rlemubaghs/open_mrscope/images/microscope_artifacts.png

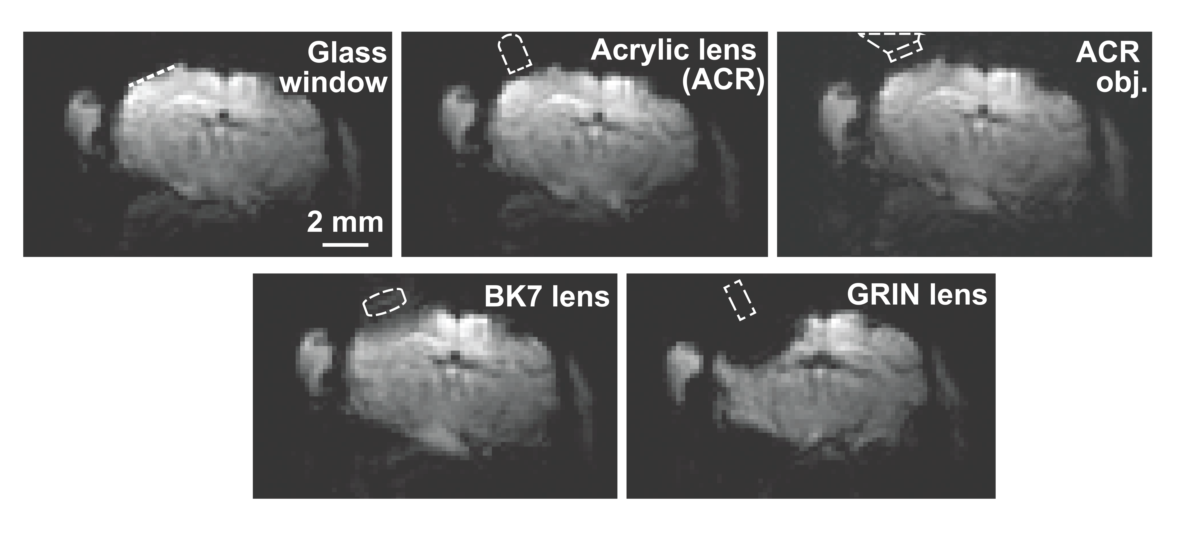
images/microscope_artifacts.png
