rlemubaghs/open_mrscope/images/microscope_overview.png

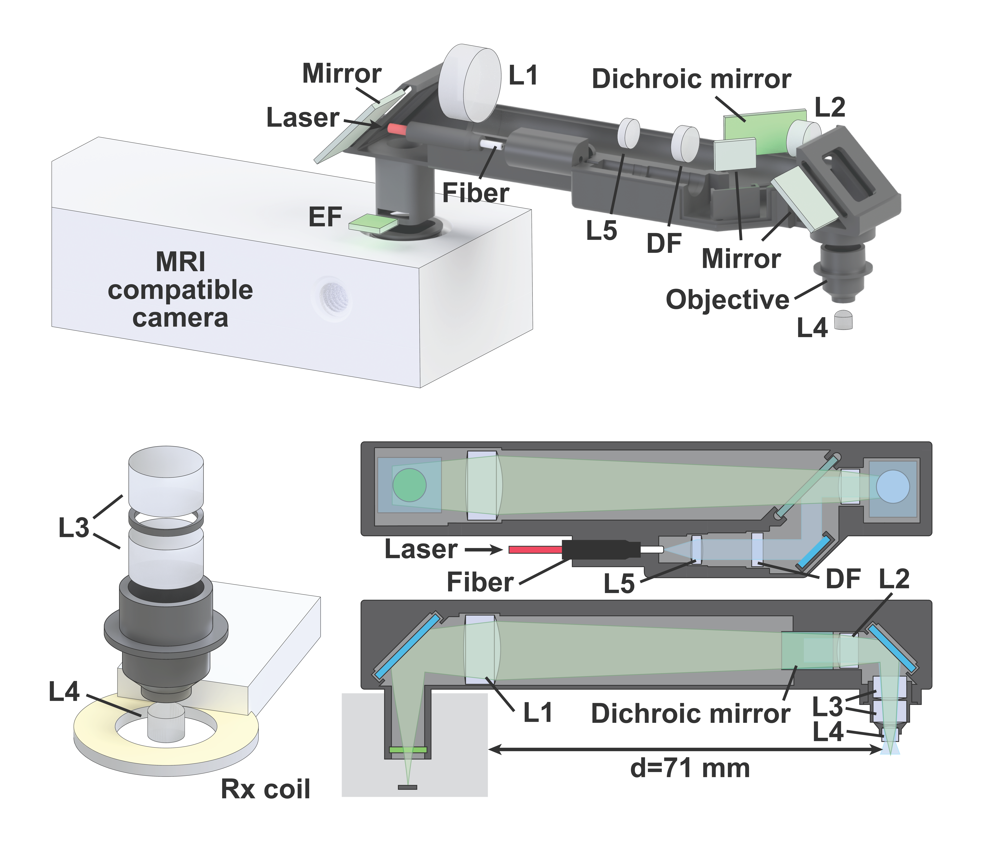
images/microscope_overview.png
