rlemubaghs/open_mrscope/documentation/order_list.docx

Ordered items

Item | # | Manufacturer | Link | Note
EO #15-271 | 1 | Edmund Optics | https://www.edmundoptics.com/p/3mm-dia-x-299mm-fl-small-diameter-plastic-aspheric-lens/43154/
EO #36-629 | 2 | Edmund Optics | https://www.edmundoptics.com/p/6mm-dia-x-8mm-fl-small-diameter-plastic-aspheric-lens/34654/ | Scratch sensitive
EO #47-662 | 1 | Edmund Optics | https://www.edmundoptics.com/p/125mm-dia-x-25mm-fl-vis-0deg-coated-achromatic-lens/7769/
EO #47-690 | 1 | Edmund Optics | https://www.edmundoptics.com/p/625mm-dia-x-125mm-fl-vis-0deg-coated-achromatic-lens/7810/
EO #63-594 | 1 | Edmund Optics | https://www.edmundoptics.com/p/5mm-dia-x-5mm-fl-vis-0deg-coated-double-convex-lens/18227/
EO #63-594 | 1 | Edmund Optics | https://www.edmundoptics.com/p/5mm-dia-x-5mm-fl-vis-0deg-coated-double-convex-lens/18227/
Custom fiber | 1 | Thorlabs | https://www.thorlabs.com/newgrouppage9.cfm?objectgroup_id=2410 | SM FC/PC; Ferrule; FP400ERT
OBIS LX/LS Series | 1 | Coherent | https://www.coherent.com/lasers/cw-solid-state/obis-ls-lx | 488 nm GCaMP; 561 nm RCaMP
HighResolution | 1 | MRC Systems | https://www.mrc-systems.de/de/produkte/mr-kompatible-kameras#hires-mrcam | Contact: m.goetz@mrc-systems.de
ET Dualband beamsplitter FITC/CY3 | 1 | AHF | https://ahf.de/produkte/spektralanalytik-photonik/optische-filter/strahlenteiler-nach-anwendung/epi-fluoreszenz/et-dualband-bs-fitc-cy3/F58-023 | 14.5 x 8 mm
350-700 nm imaging mirror | 1 | AHF | https://ahf.de/produkte/spektralanalytik-photonik/optische-filter/spiegel/350-700-nm-spiegel-imaging/F29-350 | 16.5 x 11.5 mm
350-700 nm imaging mirror | 1 | AHF | https://ahf.de/produkte/spektralanalytik-photonik/optische-filter/spiegel/350-700-nm-spiegel-imaging/F29-350 | 8.5 x 11.5 mm
350-700 nm imaging mirror | 1 | AHF | https://ahf.de/produkte/spektralanalytik-photonik/optische-filter/spiegel/350-700-nm-spiegel-imaging/F29-350 | 8 x 5.5 mm
ET Dualband Emitter FITC/CY3 | 1 | AHF | https://ahf.de/en | 6.5 x 6.5 mm
edc-10 | 1 | Rochester | https://lso.viavisolutions.com/product/edc-10/ | ⌀ 6 mm
M1.2 PEEK Countersink Screws | - | HP Polymer | https://highperformancepolymer.co.uk/en-ch/collections/peek-screws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 | Various length M1.2
M2 PEEK Countersink Screws | - | HP Polymer | https://highperformancepolymer.co.uk/en-ch/collections/peek-screws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 | Various length M2

Custom manufactured items

All items can be found in the /open_mrscope_mk2 folder as threaded and non-threaded version

Item | # | Prod. | Material | Note
adaptor_camera_mk1 | 1 | CNC | PEEK | Adopt threading to camera model
adaptor_cameralock_mk1 | 1 | CNC | Titanium | Use Grade II to minimize artifacts
adaptor_lightsource_mk1 | 1 | CNC | PEEK
adaptor_lightsourceangle_mk1 | 1 | CNC | PEEK
construction_objective_mk1 | 1 | CNC | PEEK
microscope_cameracoupler_mk1 | 1 | CNC | PEEK
microscope_filtercube_mk1 | 1 | CNC | PEEK
microscope_mirrorlockback_mk1 | 1 | CNC | PEEK
microscope_mirrorlockfront_mk1 | 1 | CNC | PEEK
microscope_mirrorlocktop_mk1 | 1 | CNC | PEEK
microscope_objective_mk1 | 1 | CNC | PEEK
microscope_objectivecoupler_mk1 | 1 | CNC | PEEK
microscope_opticaltube_mk1 | 1 | CNC | PEEK
microscope_spacer_mk1 | 1 | CNC | PEEK | Recommended spares: 3
microscope_support_mk1 | 1 | CNC/SLA/DLP | PEEK/HDT180 | Loctite 3D 3860 HDT180
microscope_supportlock_mk1 | 1 | CNC/SLA/DLP | PEEK/HDT180 | Loctite 3D 3860 HDT180
