rlemubaghs/open_mrscope/open_mrscope_mk2/production_nothread/stp/assemblies/assemblies_opticalsystem.stp

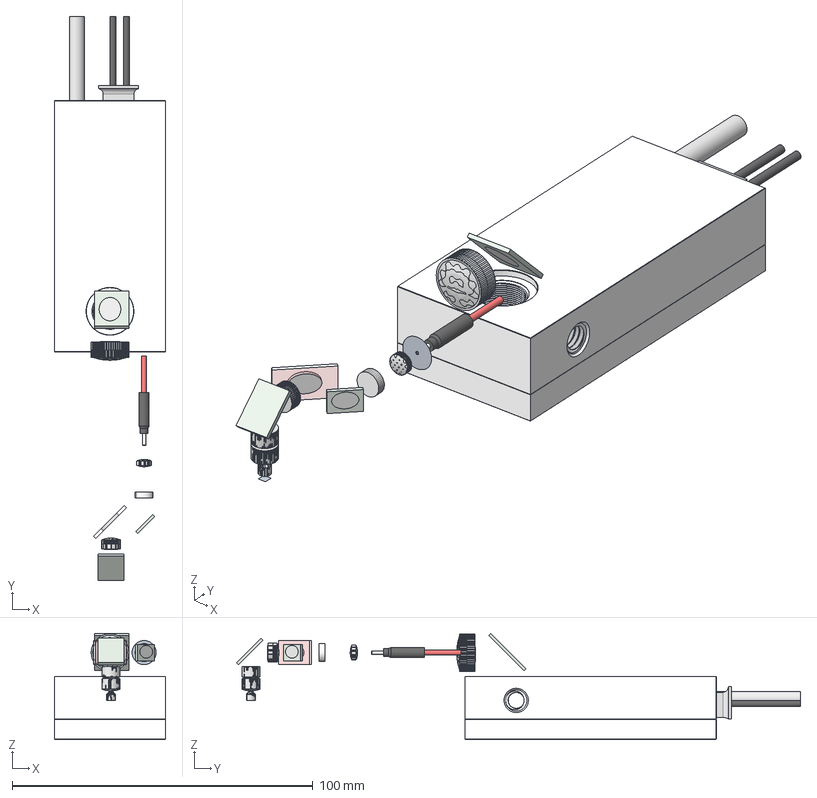
[picture p4: CAD file, 2025-03-11]
open_mrscope_mk2/production_nothread/stp/assemblies/assemblies_opticalsystem.stp
37.0 x 187.5 x 35.2 mm
filter_dichroic_ext
Filters_Diffuser_ext
Filters_Emmiter_ext
lens_15271_ext
lens_36629_ext x 2
lens_47662_ext
Lenses_47690_ext
Lenses_63594_ext
mirror_mirror10x16mm_ext
mirror_mirror5x7mm_ext
mirror_mirror8x11mm_ext
Peripherals_Cam_ext
Peripherals_Fiber_ext
filter_diffuser_ext
