rlemubaghs/open_mrscope/open_mrscope_mk2/production_nothread/stl/optics/filters/filter_emmiter_ext.stl

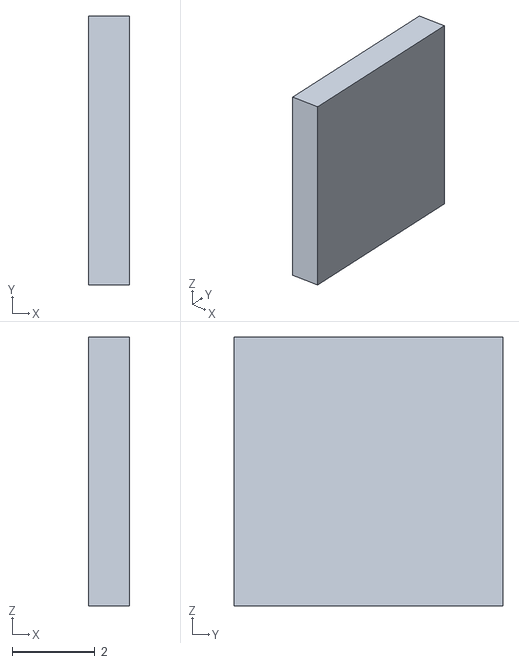
[picture p6: CAD file, 2025-03-11]
open_mrscope_mk2/production_nothread/stl/optics/filters/filter_emmiter_ext.stl
1.00 x 6.50 x 6.50
