rlemubaghs/open_mrscope/open_mrscope_mk2/production_nothread/stl/optics/lenses/lens_15271_ext.stl

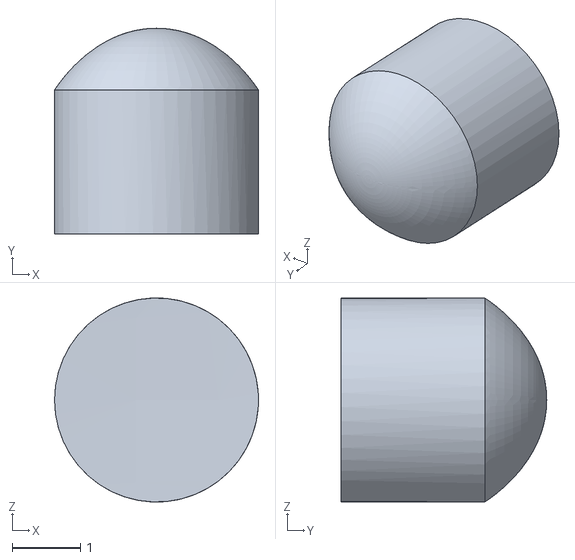
[picture p7: CAD file, 2025-03-11]
open_mrscope_mk2/production_nothread/stl/optics/lenses/lens_15271_ext.stl
3.00 x 3.02 x 3.00
