rlemubaghs/open_mrscope/open_mrscope_mk2/production_nothread/stp/adaptors/adaptor_camera_mk1.stp

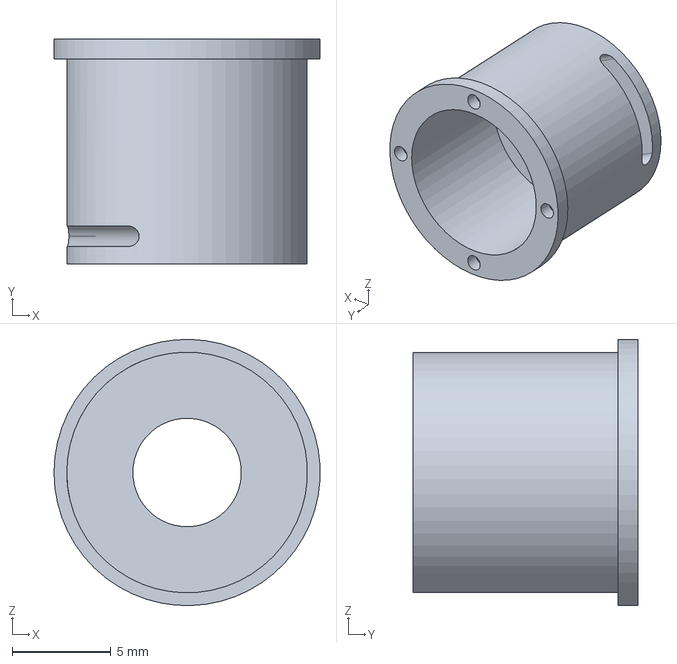
[picture p8: CAD file, 2025-03-11]
open_mrscope_mk2/production_nothread/stp/adaptors/adaptor_camera_mk1.stp
13.5 x 11.4 x 13.5 mm
