rlemubaghs/open_mrscope/open_mrscope_mk2/production_nothread/stp/construction/construction_objective_mk1.stp

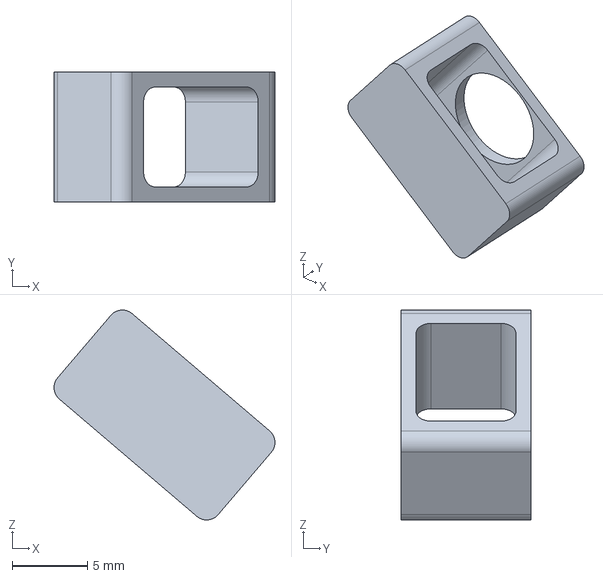
[picture p9: CAD file, 2025-03-11]
open_mrscope_mk2/production_nothread/stp/construction/construction_objective_mk1.stp
14.7 x 8.62 x 13.9 mm
