rlemubaghs/open_mrscope/open_mrscope_mk2/production_nothread/stp/microscope/microscope_mirrorlockback_mk1.stp

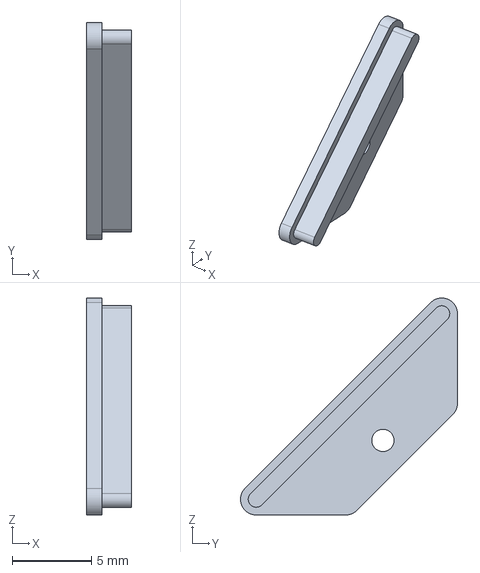
[picture p10: CAD file, 2025-03-11]
open_mrscope_mk2/production_nothread/stp/microscope/microscope_mirrorlockback_mk1.stp
2.87 x 13.7 x 13.7 mm
