rlemubaghs/open_mrscope/open_mrscope_mk2/production_nothread/stp/optics/filters/filter_diffuser_ext.stp

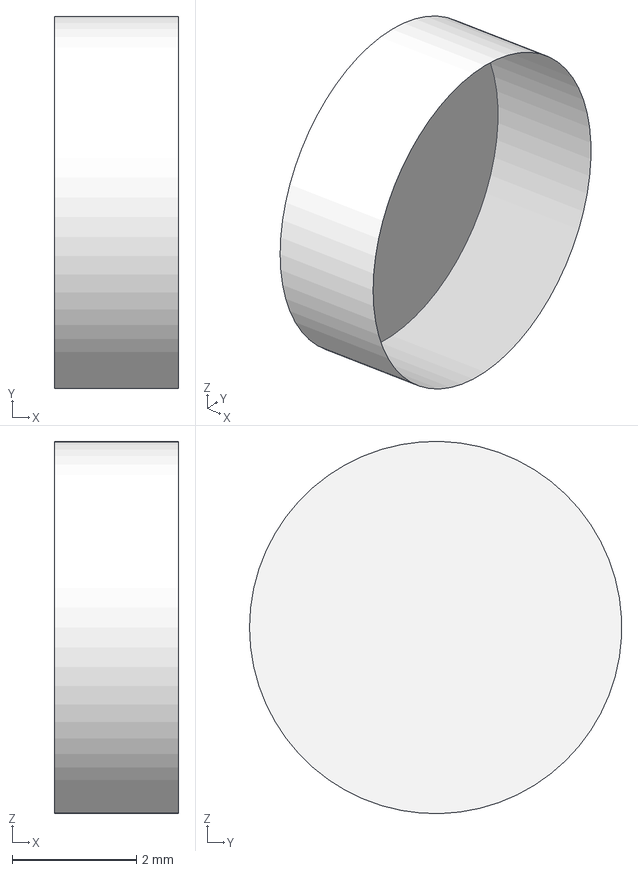
[picture p11: CAD file, 2025-03-11]
open_mrscope_mk2/production_nothread/stp/optics/filters/filter_diffuser_ext.stp
2.00 x 6.00 x 6.00 mm
