rlemubaghs/open_mrscope/open_mrscope_mk2/production_nothread/stp/optics/lenses/lens_36629_ext.stp

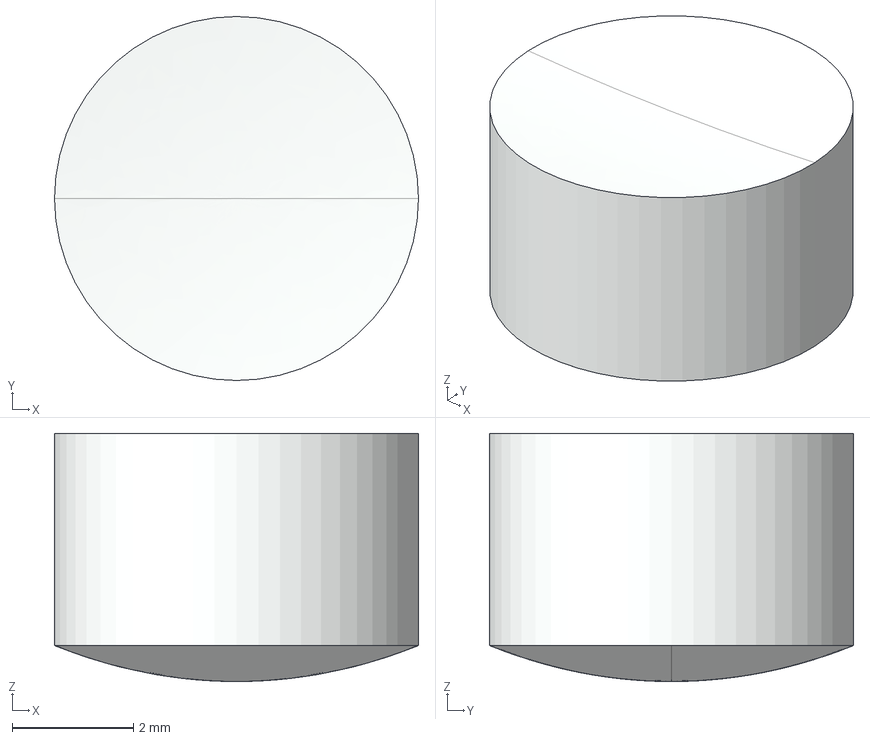
[picture p12: CAD file, 2025-03-11]
open_mrscope_mk2/production_nothread/stp/optics/lenses/lens_36629_ext.stp
6.00 x 6.00 x 4.09 mm
