rlemubaghs/open_mrscope/open_mrscope_mk2/production_nothread/stp/optics/mirrors/mirror_mirror16x11mm_ext.stp

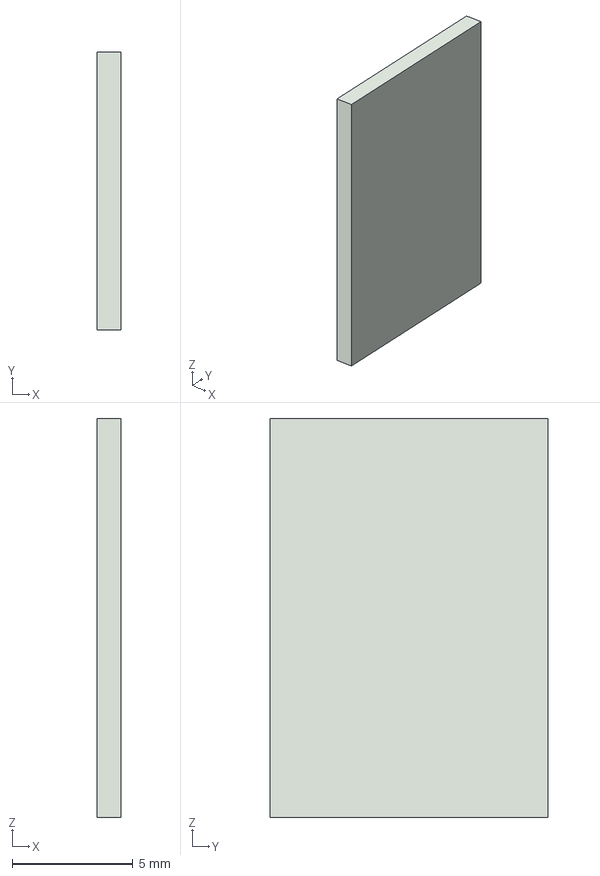
[picture p13: CAD file, 2025-03-11]
open_mrscope_mk2/production_nothread/stp/optics/mirrors/mirror_mirror16x11mm_ext.stp
1.00 x 11.5 x 16.5 mm
