rlemubaghs/open_mrscope/open_mrscope_mk2/production_nothread/stp/optics/simulation/camera.stp

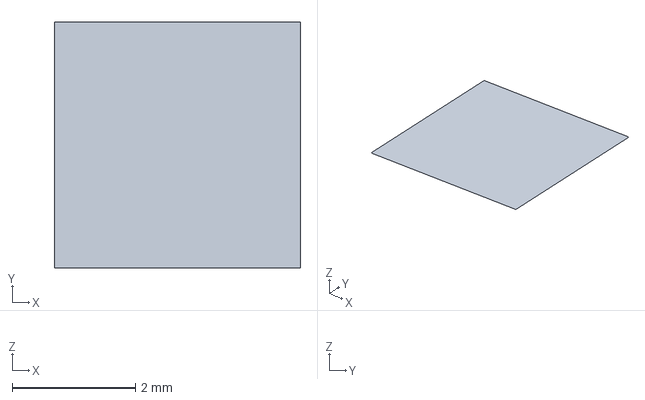
[picture p14: CAD file, 2025-03-11]
open_mrscope_mk2/production_nothread/stp/optics/simulation/camera.stp
4.00 x 4.00 x 0 mm
