rlemubaghs/open_mrscope/open_mrscope_mk2/production_nothread/stp/peripherals/peripheral_camera_ext.stp

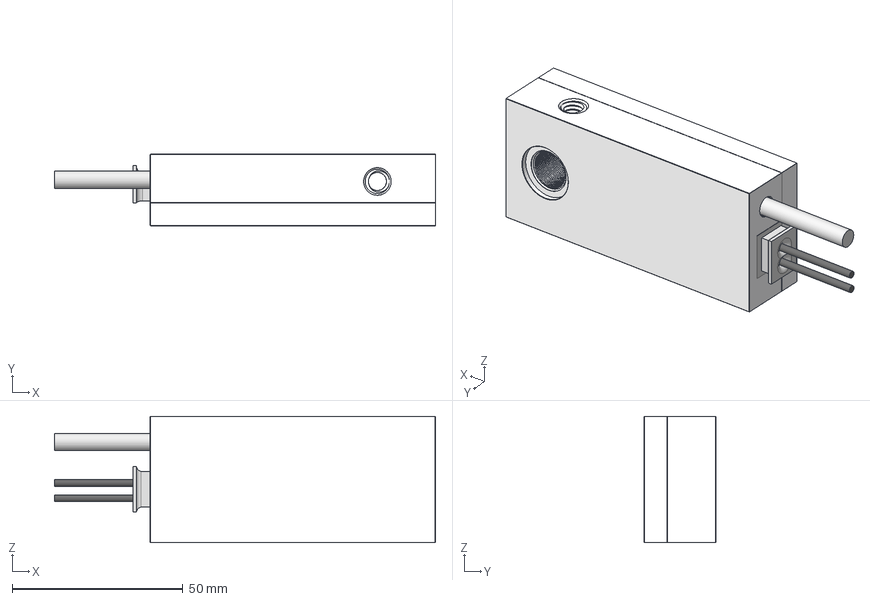
[picture p15: CAD file, 2025-03-11]
open_mrscope_mk2/production_nothread/stp/peripherals/peripheral_camera_ext.stp
111.5 x 21.0 x 37.0 mm
