rlemubaghs/open_mrscope/open_mrscope_mk2/production_thread/stl/optics/mirrors/mirror_mirror5x8mm_ext.stl

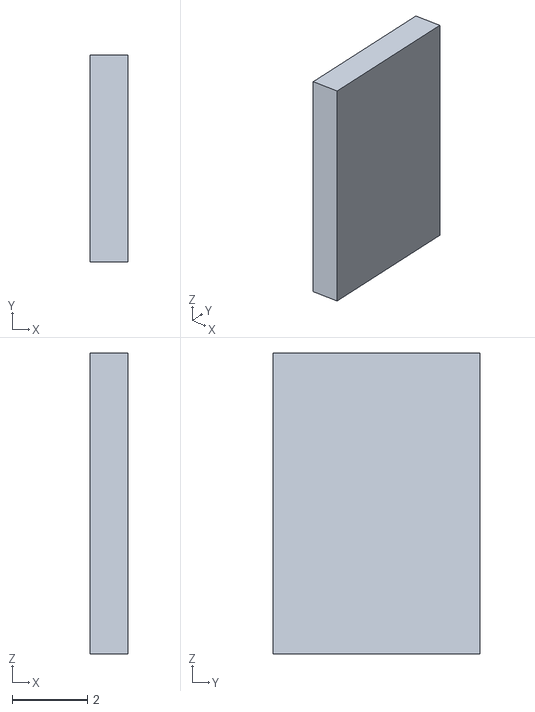
[picture p16: CAD file, 2025-03-11]
open_mrscope_mk2/production_thread/stl/optics/mirrors/mirror_mirror5x8mm_ext.stl
1.00 x 5.50 x 8.00
