rlemubaghs/open_mrscope/open_mrscope_mk2/production_thread/stl/optics/simulation/lens_47662_ext_2.stl

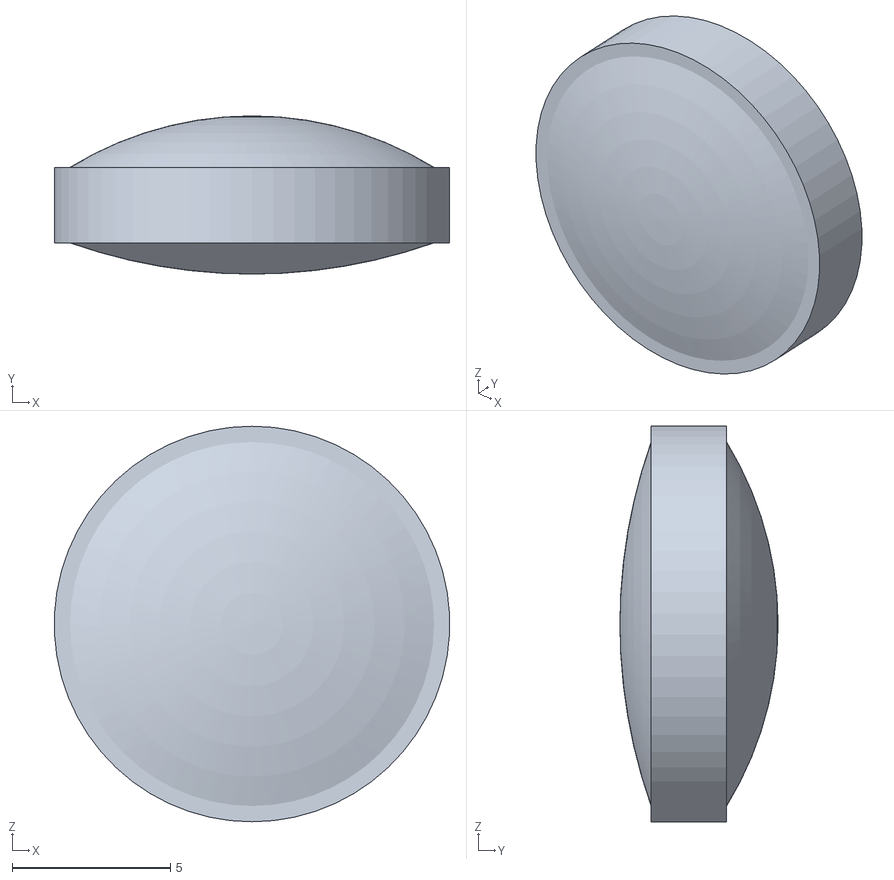
[picture p17: CAD file, 2025-03-11]
open_mrscope_mk2/production_thread/stl/optics/simulation/lens_47662_ext_2.stl
12.5 x 5.00 x 12.5
