rlemubaghs/open_mrscope/open_mrscope_mk2/production_thread/stl/peripherals/peripheral_fiber_ext.stl

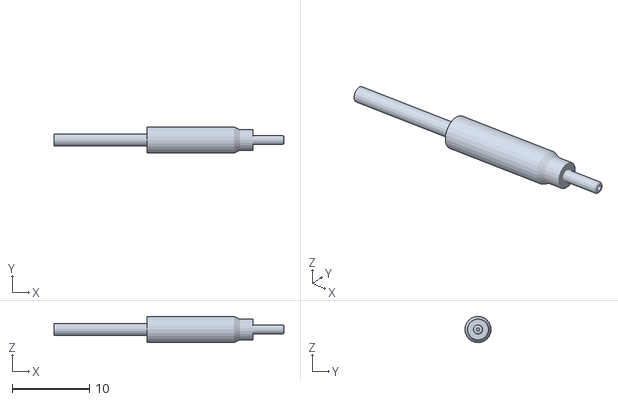
[picture p18: CAD file, 2025-03-11]
open_mrscope_mk2/production_thread/stl/peripherals/peripheral_fiber_ext.stl
29.7 x 3.40 x 3.40
