rlemubaghs/open_mrscope/open_mrscope_mk2/production_thread/stp/optics/filters/filter_dichroic_ext.stp

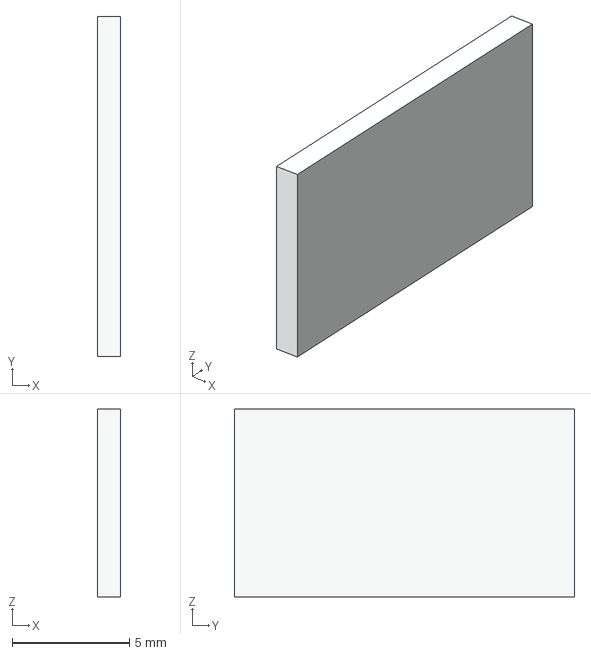
[picture p21: CAD file, 2025-03-11]
open_mrscope_mk2/production_thread/stp/optics/filters/filter_dichroic_ext.stp
1.00 x 14.5 x 8.00 mm
