rlemubaghs/open_mrscope/open_mrscope_mk2/production_thread/stp/optics/lenses/lens_63594_ext.stp

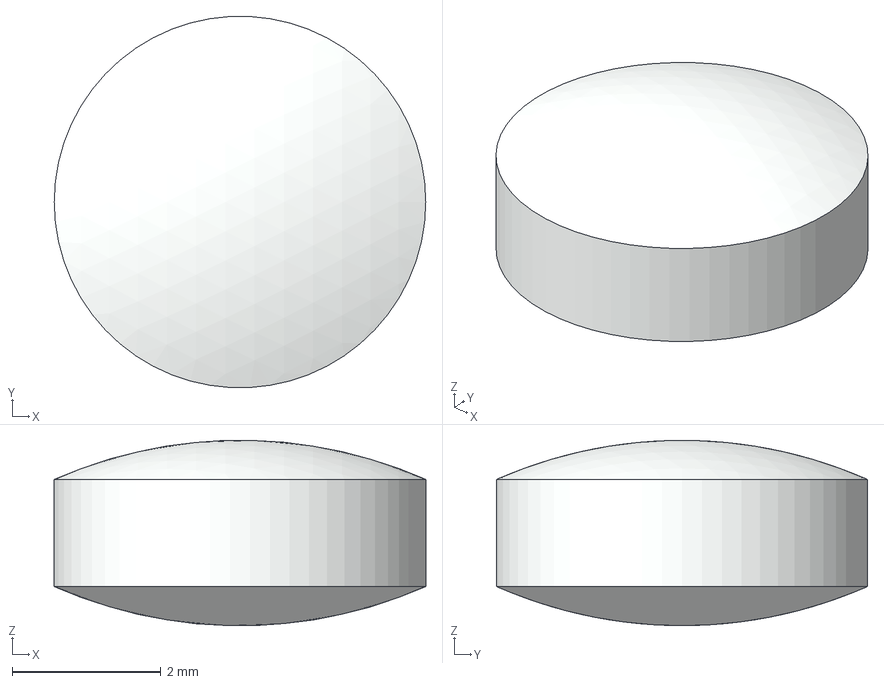
[picture p22: CAD file, 2025-03-11]
open_mrscope_mk2/production_thread/stp/optics/lenses/lens_63594_ext.stp
5.00 x 4.99 x 2.49 mm
