rlemubaghs/open_mrscope/open_mrscope_mk2/production_thread/stp/optics/mirrors/mirror_mirror8x11mm_ext.stp

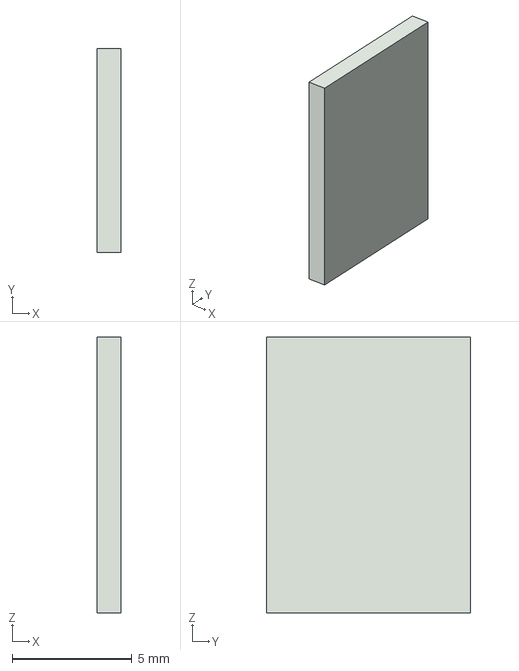
[picture p23: CAD file, 2025-03-11]
open_mrscope_mk2/production_thread/stp/optics/mirrors/mirror_mirror8x11mm_ext.stp
1.00 x 8.50 x 11.5 mm
