rlemubaghs/open_mrscope/open_mrscope_mk2/production_thread/stp/optics/simulation/lens_47690_ext_2.stp

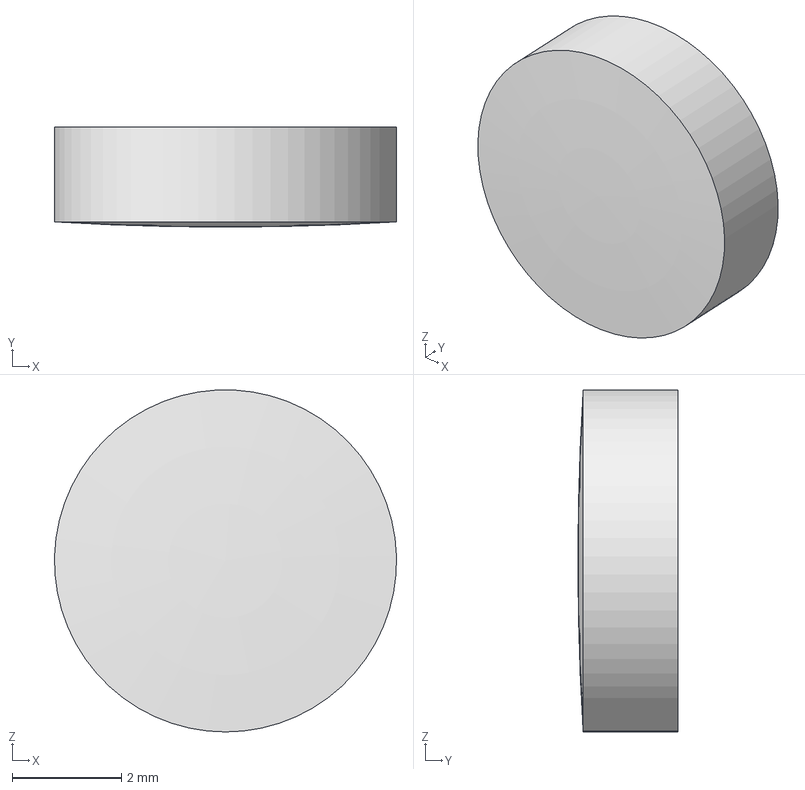
[picture p24: CAD file, 2025-03-11]
open_mrscope_mk2/production_thread/stp/optics/simulation/lens_47690_ext_2.stp
6.25 x 1.83 x 6.25 mm
