rlemubaghs/open_mrscope/production/stp/construction/construction_buildplate_mk1.stp

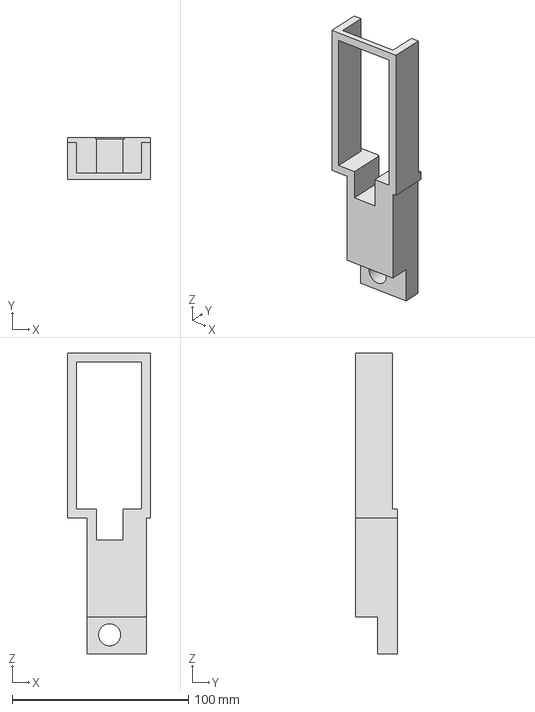
[picture p25: CAD file, 2023-11-07]
production/stp/construction/construction_buildplate_mk1.stp
47.0 x 23.6 x 170.6 mm
