rlemubaghs/open_mrscope/production/stp/optics/mirrors/mirror_mirror8x11mm_ext.stp

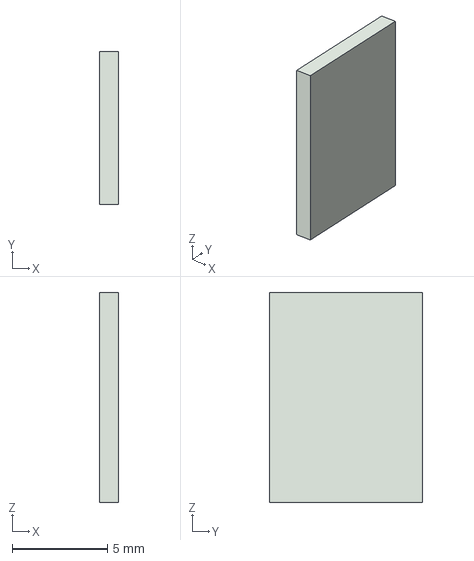
[picture p27: CAD file, 2023-11-07]
production/stp/optics/mirrors/mirror_mirror8x11mm_ext.stp
1.00 x 8.00 x 11.0 mm
