rlemubaghs/open_mrscope/production/stp/peripherals/peripheral_fiber_ext.stp

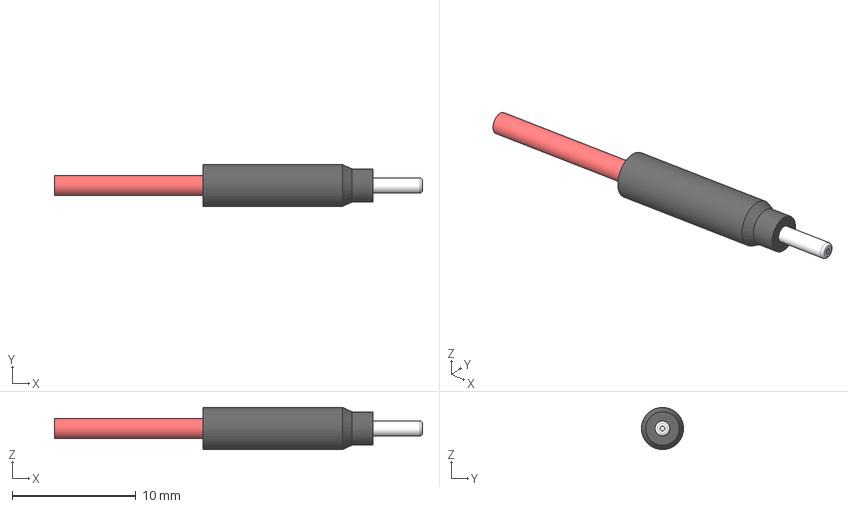
[picture p28: CAD file, 2023-11-07]
production/stp/peripherals/peripheral_fiber_ext.stp
29.7 x 3.40 x 3.40 mm
