rlemubaghs/open_mrscope/open_mrscope_mk2/production_nothread/stl/optics/lenses/lens_47690_ext.stl

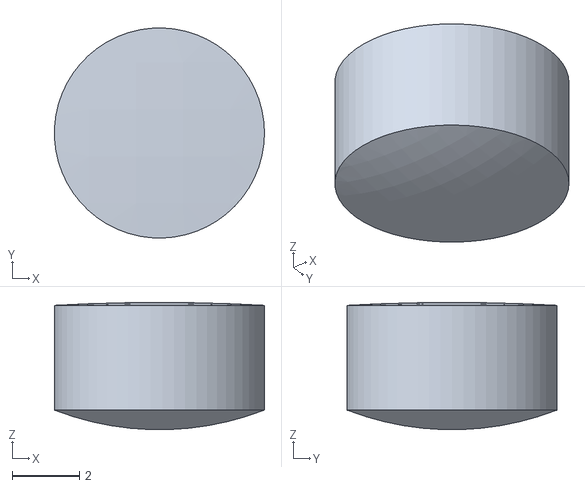
[picture p29: CAD file, 2025-03-11]
open_mrscope_mk2/production_nothread/stl/optics/lenses/lens_47690_ext.stl
6.25 x 6.25 x 3.78
