rlemubaghs/open_mrscope/open_mrscope_mk2/production_nothread/stp/adaptors/adaptor_lightsourceangle_mk1.stp

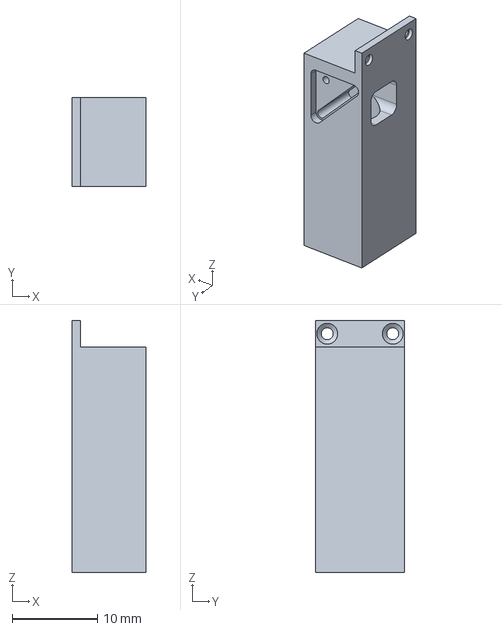
[picture p30: CAD file, 2025-03-11]
open_mrscope_mk2/production_nothread/stp/adaptors/adaptor_lightsourceangle_mk1.stp
8.75 x 10.5 x 29.6 mm
