rlemubaghs/open_mrscope/open_mrscope_mk2/production_nothread/stp/microscope/microscope_supportlock_mk1.stp

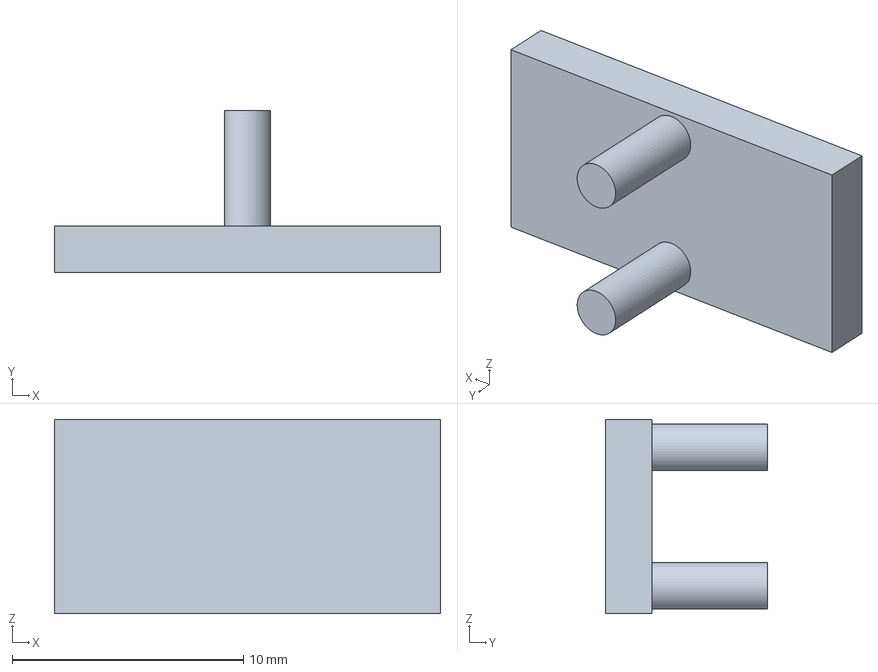
[picture p31: CAD file, 2025-03-11]
open_mrscope_mk2/production_nothread/stp/microscope/microscope_supportlock_mk1.stp
16.7 x 7.00 x 8.40 mm
