rlemubaghs/open_mrscope/open_mrscope_mk2/production_nothread/stp/optics/simulation/mirror_mirror5x7mm_ext.stp

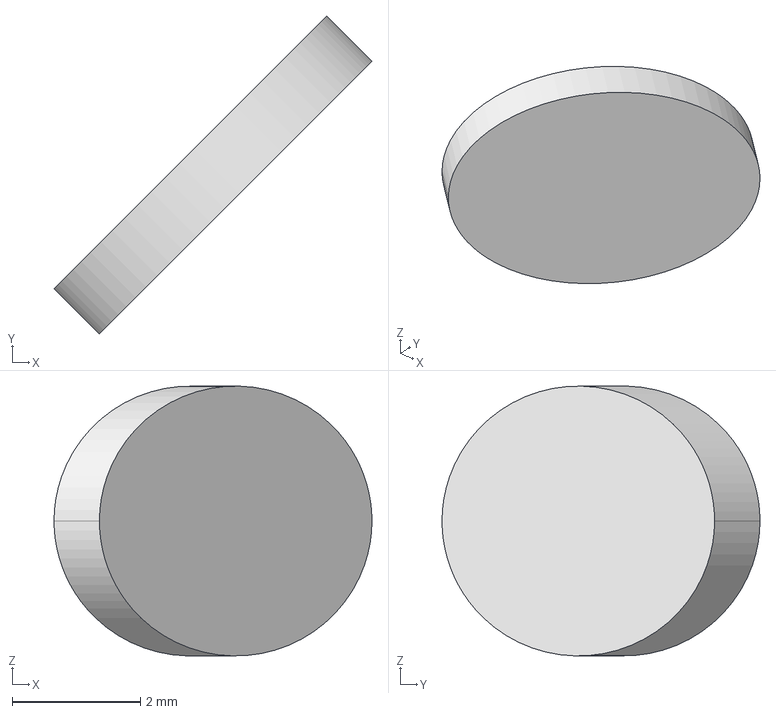
[picture p32: CAD file, 2025-03-11]
open_mrscope_mk2/production_nothread/stp/optics/simulation/mirror_mirror5x7mm_ext.stp
4.95 x 4.95 x 4.20 mm
