rlemubaghs/open_mrscope/open_mrscope_mk2/production_thread/stl/optics/simulation/filter_emmiter_ext.stl

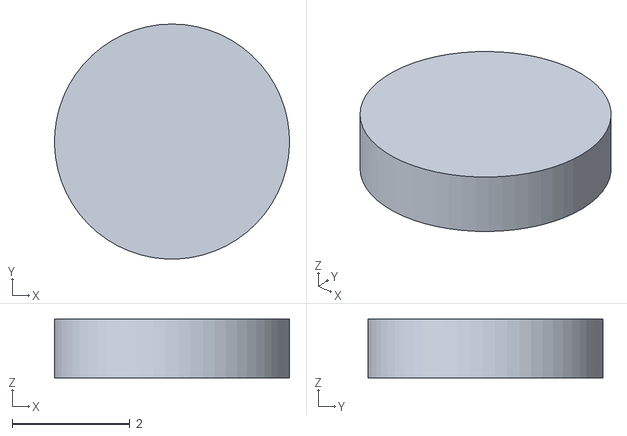
[picture p33: CAD file, 2025-03-11]
open_mrscope_mk2/production_thread/stl/optics/simulation/filter_emmiter_ext.stl
4.00 x 4.00 x 1
