rlemubaghs/open_mrscope/open_mrscope_mk2/production_thread/stp/adaptors/adaptor_cameralock_mk1.stp

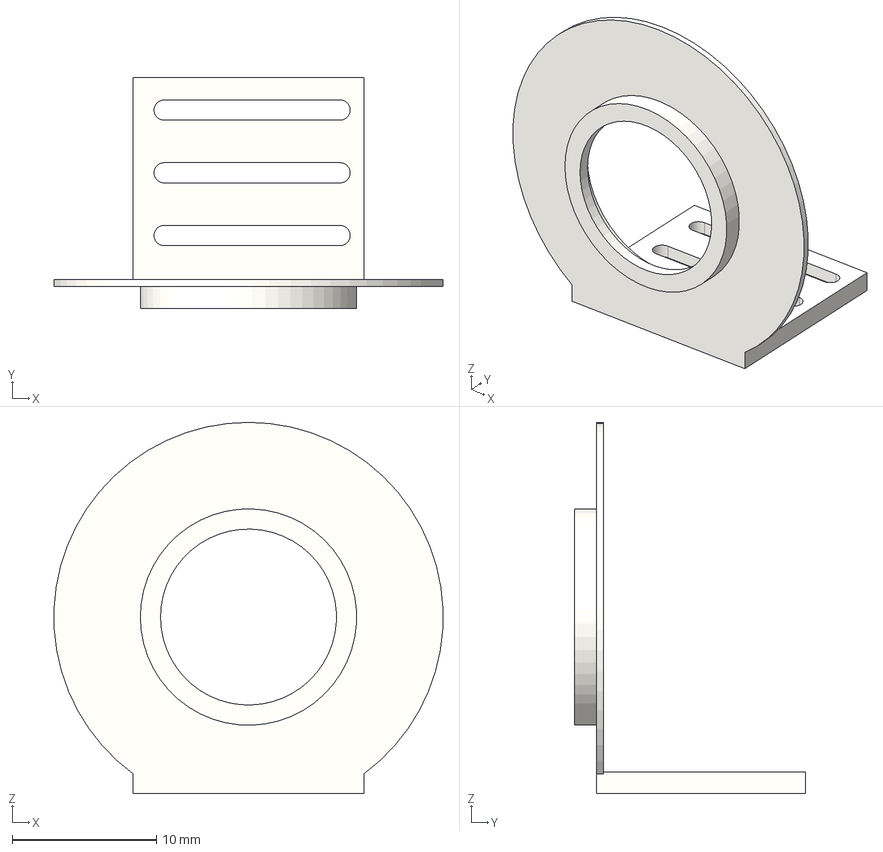
[picture p34: CAD file, 2025-03-11]
open_mrscope_mk2/production_thread/stp/adaptors/adaptor_cameralock_mk1.stp
27.0 x 16.0 x 25.7 mm
