rlemubaghs/open_mrscope/open_mrscope_mk2/production_thread/stp/optics/lenses/lens_47662_ext.stp

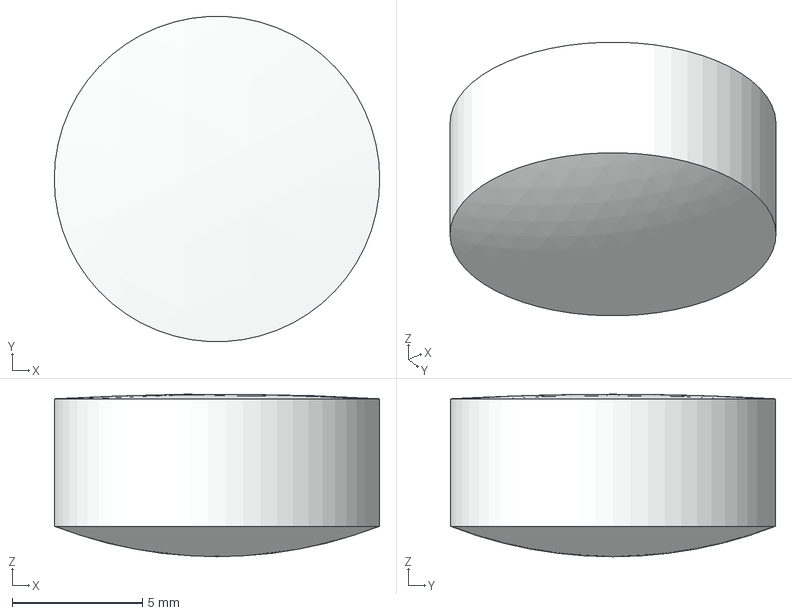
[picture p36: CAD file, 2025-03-11]
open_mrscope_mk2/production_thread/stp/optics/lenses/lens_47662_ext.stp
12.5 x 12.5 x 6.24 mm
