rlemubaghs/open_mrscope/open_mrscope_mk2/production_thread/stp/optics/simulation/light_source.stp

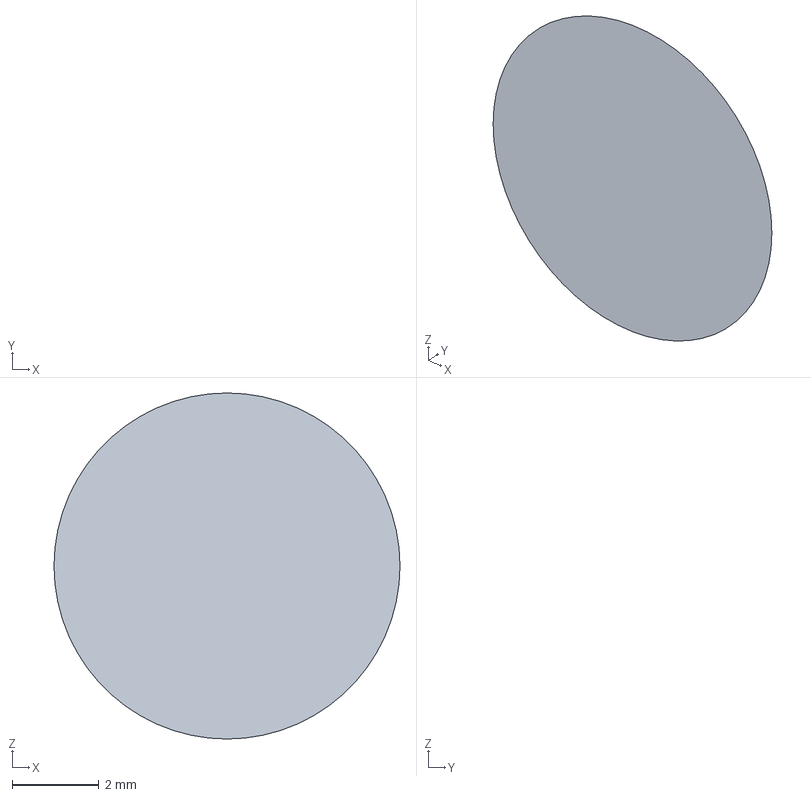
[picture p37: CAD file, 2025-03-11]
open_mrscope_mk2/production_thread/stp/optics/simulation/light_source.stp
8.00 x 0 x 8.00 mm
