rlemubaghs/open_mrscope/production/stp/construction/construction_objective_mk1.stp

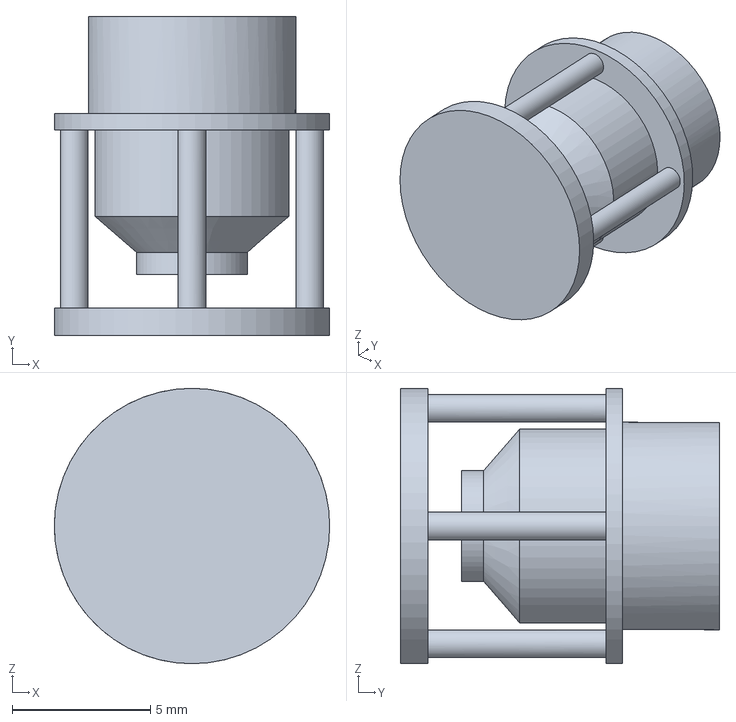
[picture p38: CAD file, 2023-11-07]
production/stp/construction/construction_objective_mk1.stp
9.95 x 11.5 x 9.95 mm
