rlemubaghs/open_mrscope/production/stp/microscope/microscope_base_mk1.stp

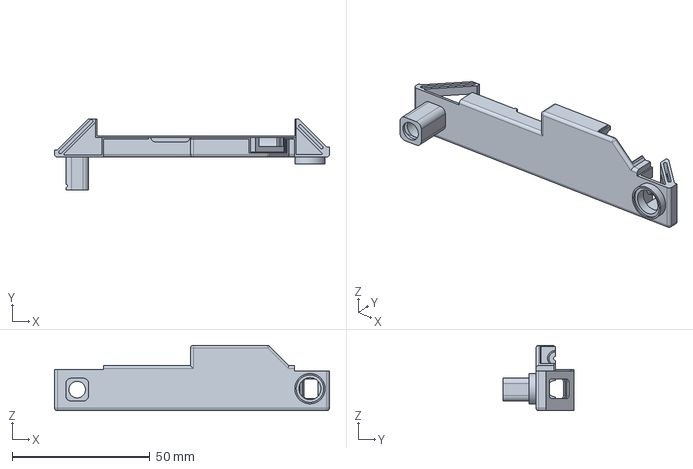
[picture p39: CAD file, 2023-11-07]
production/stp/microscope/microscope_base_mk1.stp
99.9 x 25.8 x 23.8 mm
