rlemubaghs/open_mrscope/production/stp/optics/mirrors/mirror_mirror5x7mm_ext.stp

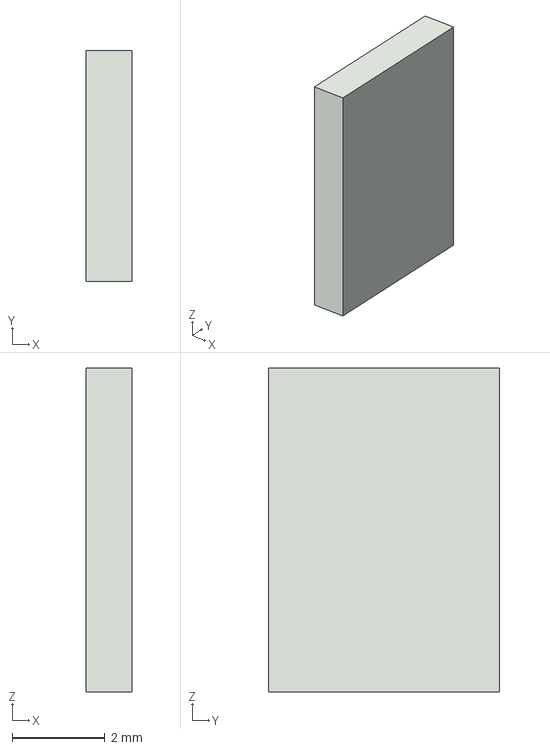
[picture p40: CAD file, 2023-11-07]
production/stp/optics/mirrors/mirror_mirror5x7mm_ext.stp
1.00 x 5.00 x 7.00 mm
