rlemubaghs/open_mrscope/open_mrscope_mk2/production_nothread/stp/adaptors/adaptor_lightsource_mk1.stp

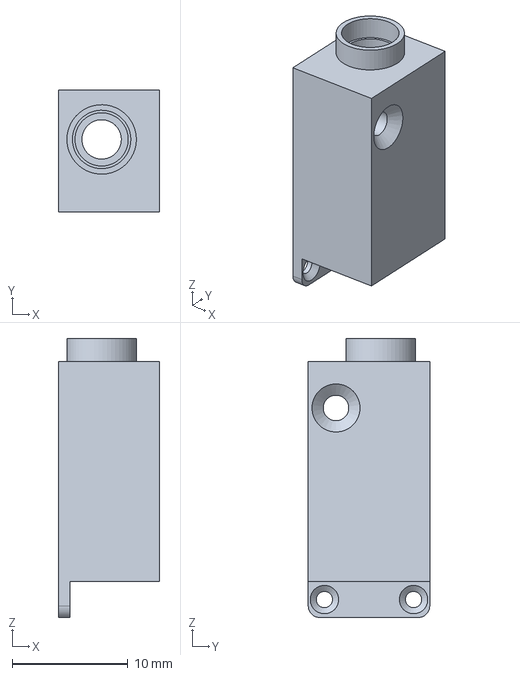
[picture p41: CAD file, 2025-03-11]
open_mrscope_mk2/production_nothread/stp/adaptors/adaptor_lightsource_mk1.stp
8.75 x 10.5 x 24.1 mm
