rlemubaghs/open_mrscope/open_mrscope_mk2/production_nothread/stp/optics/simulation/mirror_mirror10x16mm_ext.stp

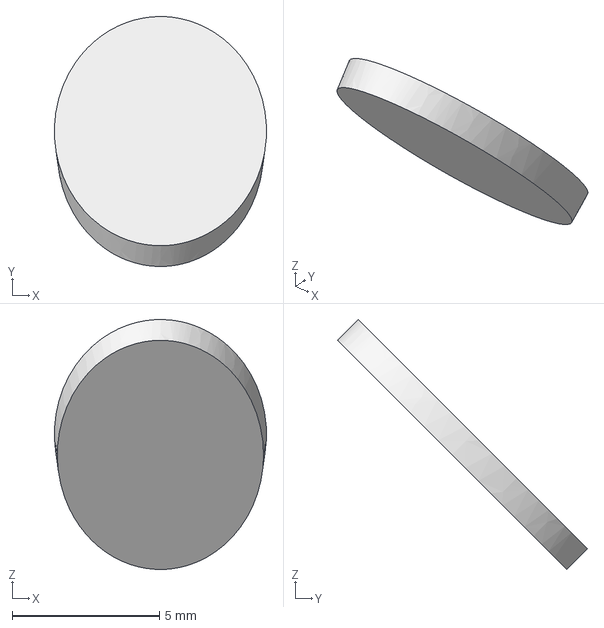
[picture p42: CAD file, 2025-03-11]
open_mrscope_mk2/production_nothread/stp/optics/simulation/mirror_mirror10x16mm_ext.stp
7.20 x 8.48 x 8.49 mm
