rlemubaghs/open_mrscope/open_mrscope_mk2/production_thread/stp/optics/simulation/lens_47662_ext_1.stp

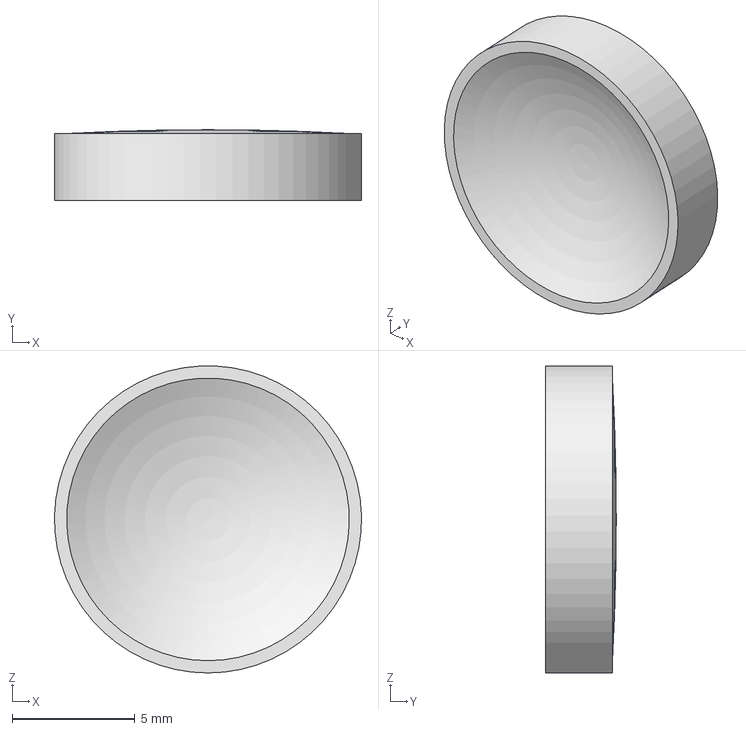
[picture p43: CAD file, 2025-03-11]
open_mrscope_mk2/production_thread/stp/optics/simulation/lens_47662_ext_1.stp
12.5 x 2.87 x 12.5 mm
