rlemubaghs/open_mrscope/production/stp/microscope/microscope_blocker_mk1.stp

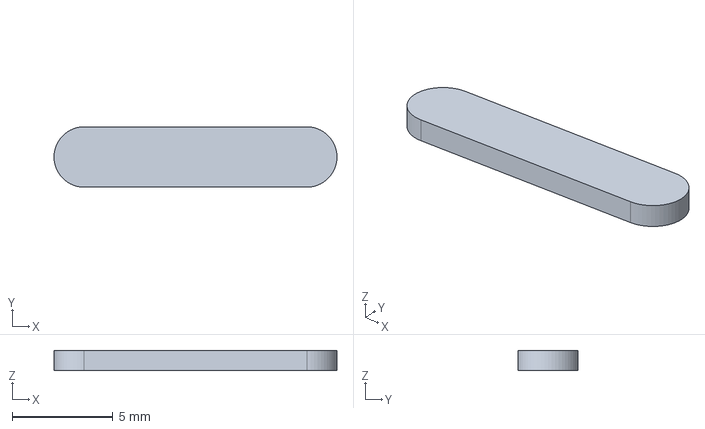
[picture p44: CAD file, 2023-11-07]
production/stp/microscope/microscope_blocker_mk1.stp
14.0 x 3.00 x 1.00 mm
