rlemubaghs/open_mrscope/production/stp/optics/mirrors/mirror_mirror10x16mm_ext.stp

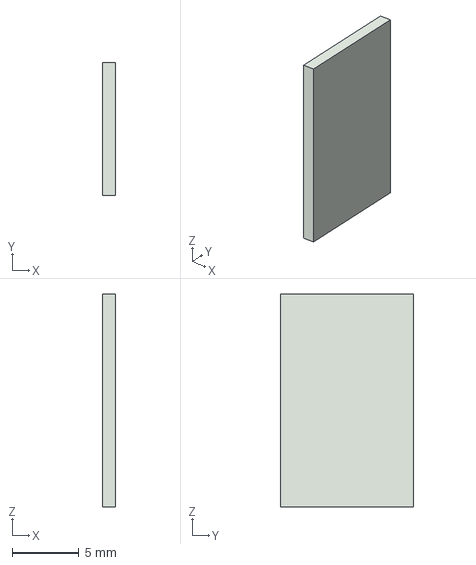
[picture p45: CAD file, 2023-11-07]
production/stp/optics/mirrors/mirror_mirror10x16mm_ext.stp
1.00 x 10.0 x 16.0 mm
