rlemubaghs/open_mrscope/open_mrscope_mk2/production_thread/stp/microscope/microscope_mirrorlocktop_mk1.stp

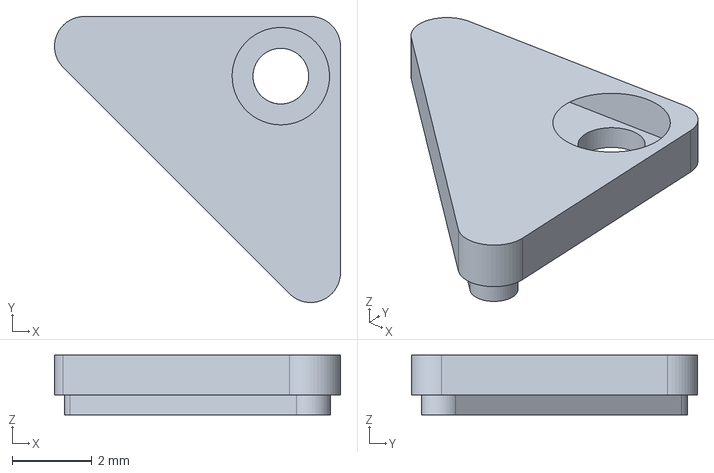
[picture p47: CAD file, 2025-03-11]
open_mrscope_mk2/production_thread/stp/microscope/microscope_mirrorlocktop_mk1.stp
7.19 x 7.19 x 1.50 mm
