rlemubaghs/open_mrscope/production/stp/microscope/microscope_top_mk1.stp

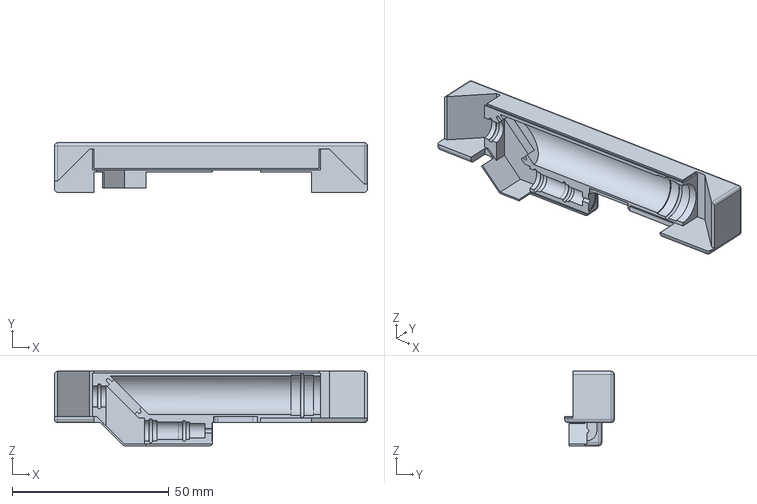
[picture p48: CAD file, 2023-11-07]
production/stp/microscope/microscope_top_mk1.stp
99.9 x 15.8 x 23.8 mm
