rlemubaghs/open_mrscope/open_mrscope_mk2/production_nothread/stp/optics/simulation/object.stp

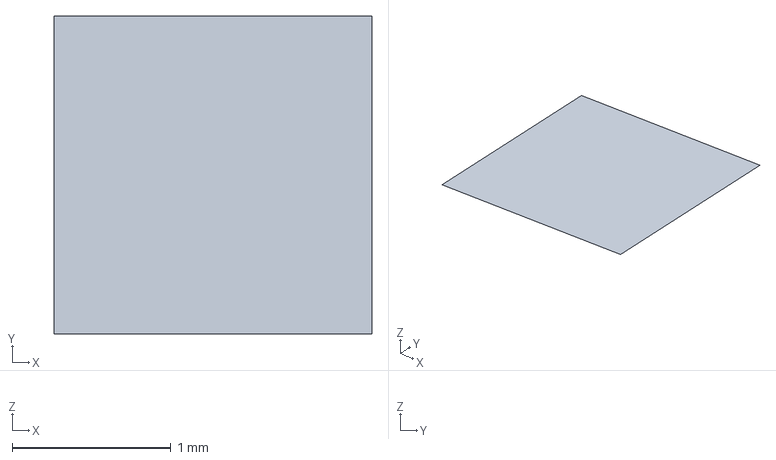
[picture p50: CAD file, 2025-03-11]
open_mrscope_mk2/production_nothread/stp/optics/simulation/object.stp
2.00 x 2.00 x 0 mm
