rlemubaghs/open_mrscope/open_mrscope_mk2/production_thread/stl/optics/simulation/filter_dichroic_ext.stl

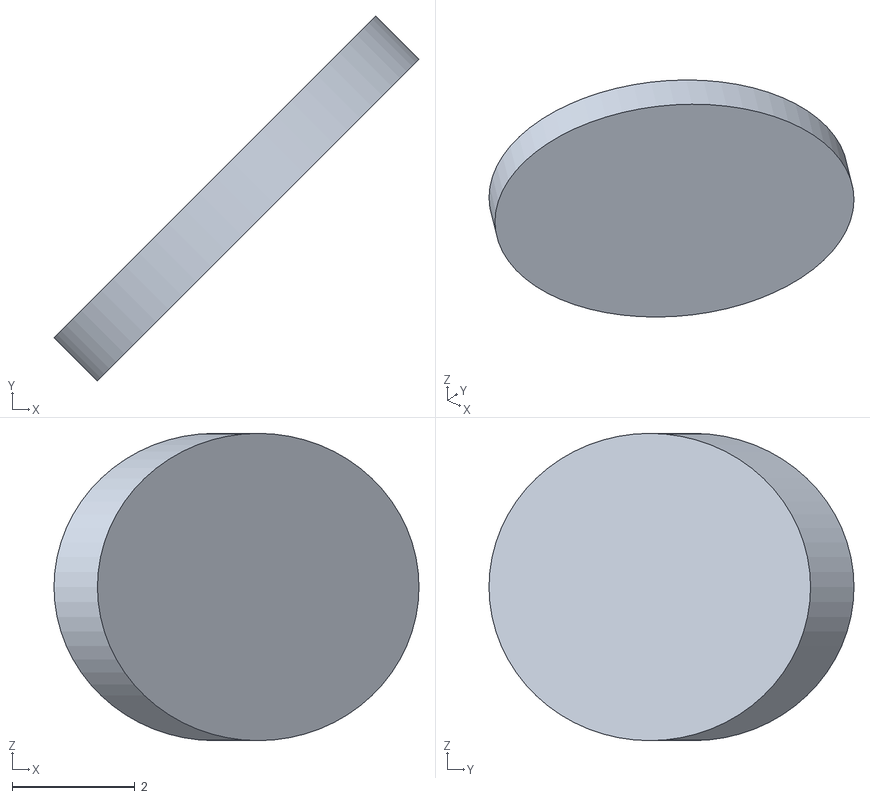
[picture p51: CAD file, 2025-03-11]
open_mrscope_mk2/production_thread/stl/optics/simulation/filter_dichroic_ext.stl
5.94 x 5.94 x 5.00
