rlemubaghs/open_mrscope/open_mrscope_mk2/production_thread/stp/microscope/microscope_mirrorlockfront_mk1.stp

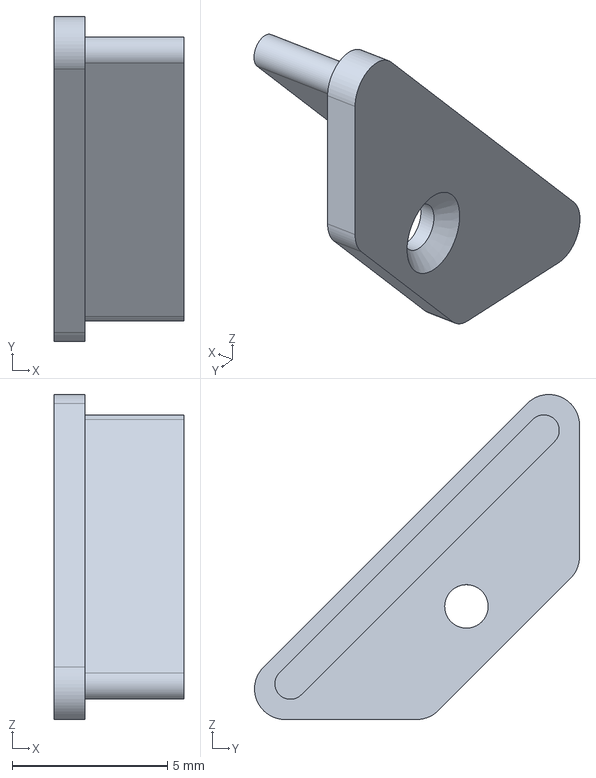
[picture p52: CAD file, 2025-03-11]
open_mrscope_mk2/production_thread/stp/microscope/microscope_mirrorlockfront_mk1.stp
4.19 x 10.5 x 10.5 mm
