rlemubaghs/open_mrscope/open_mrscope_mk2/production_thread/stp/optics/simulation/mirror_mirror8x11mm_ext.stp

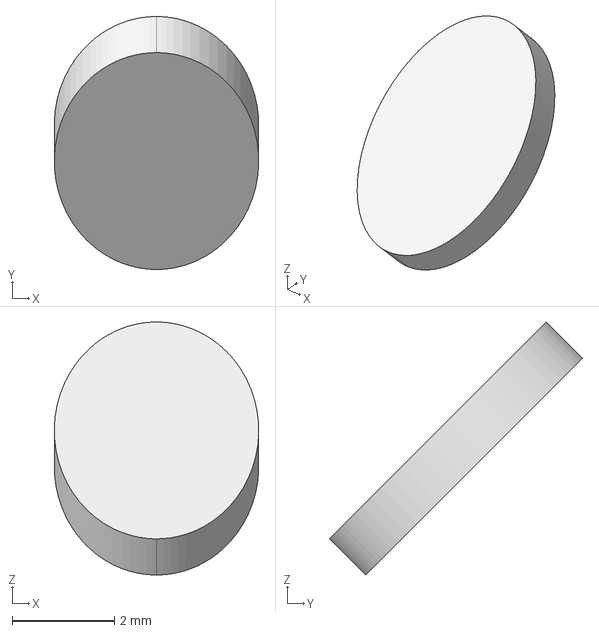
[picture p53: CAD file, 2025-03-11]
open_mrscope_mk2/production_thread/stp/optics/simulation/mirror_mirror8x11mm_ext.stp
4.00 x 4.95 x 4.95 mm
