rlemubaghs/open_mrscope/production/stp/microscope/microscope_spacer_mk1.stp

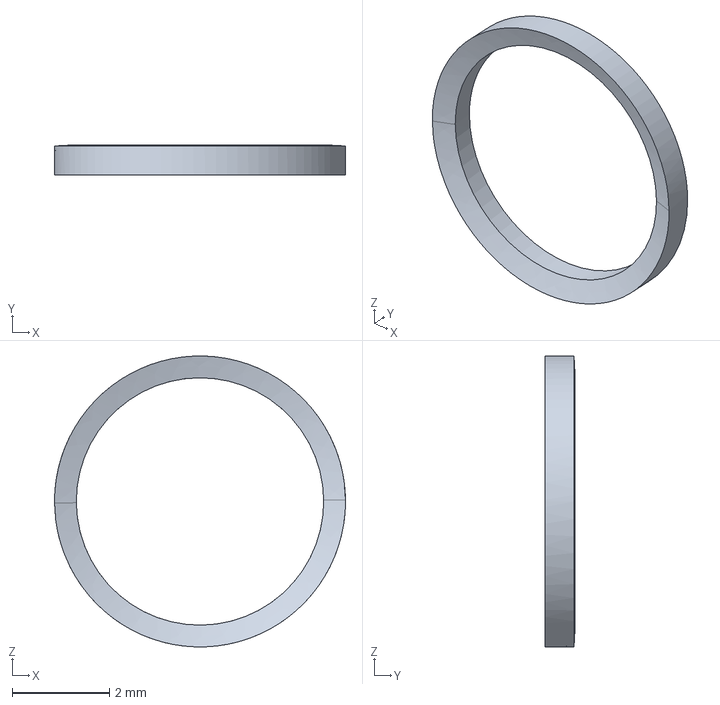
[picture p54: CAD file, 2023-11-07]
production/stp/microscope/microscope_spacer_mk1.stp
6.00 x 0.628 x 6.00 mm
