rlemubaghs/open_mrscope/open_mrscope_mk2/production_nothread/stp/microscope/microscope_objectivecoupler_mk1.stp

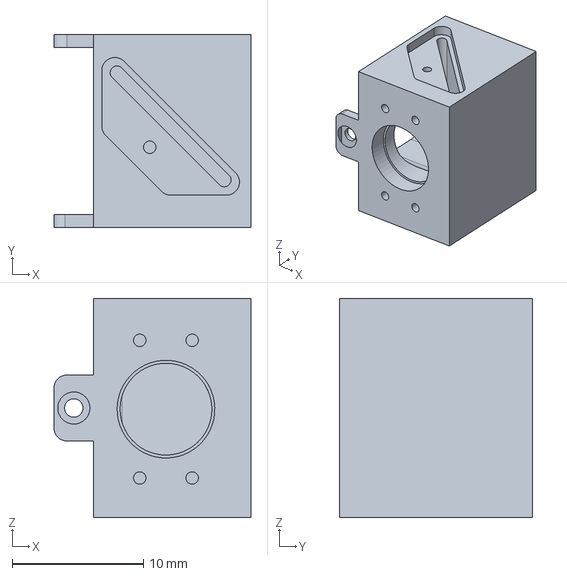
[picture p55: CAD file, 2025-03-11]
open_mrscope_mk2/production_nothread/stp/microscope/microscope_objectivecoupler_mk1.stp
15.0 x 14.7 x 16.7 mm
