rlemubaghs/open_mrscope/open_mrscope_mk2/production_nothread/stp/optics/simulation/lens_47662_ext_2.stp

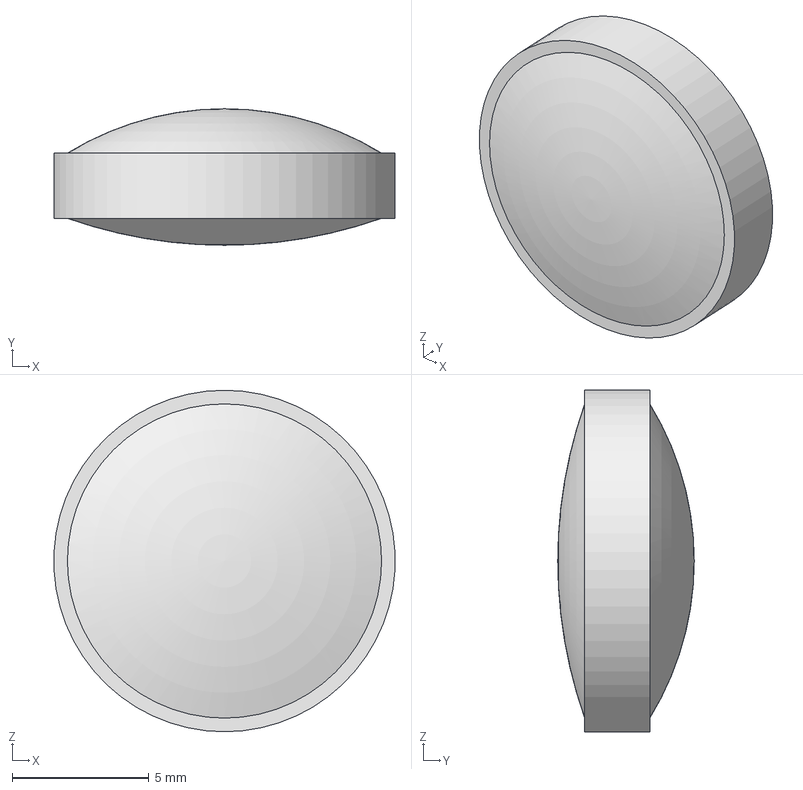
[picture p56: CAD file, 2025-03-11]
open_mrscope_mk2/production_nothread/stp/optics/simulation/lens_47662_ext_2.stp
12.5 x 5.00 x 12.5 mm
