rlemubaghs/open_mrscope/open_mrscope_mk2/production_thread/stl/optics/simulation/lens_47690_ext_1.stl

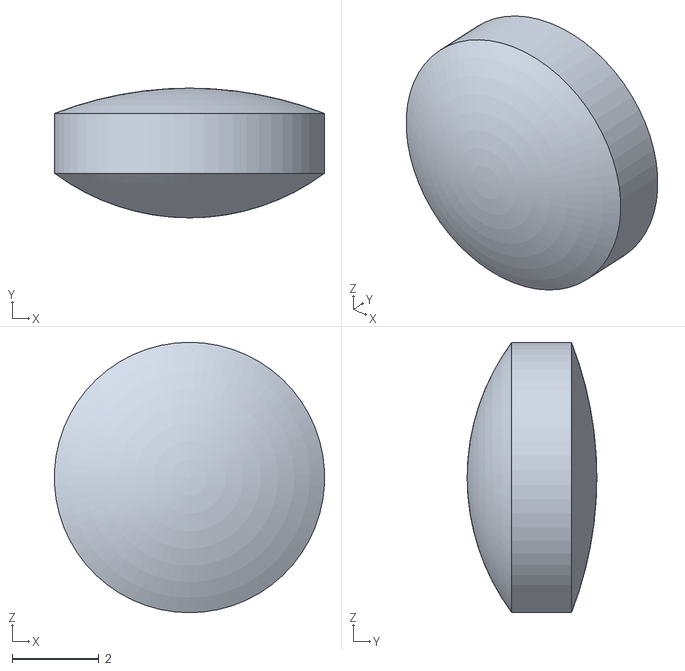
[picture p57: CAD file, 2025-03-11]
open_mrscope_mk2/production_thread/stl/optics/simulation/lens_47690_ext_1.stl
6.24 x 3.00 x 6.25
