rlemubaghs/open_mrscope/production/stp/microscope/microscope_mirrorcage_mk1.stp

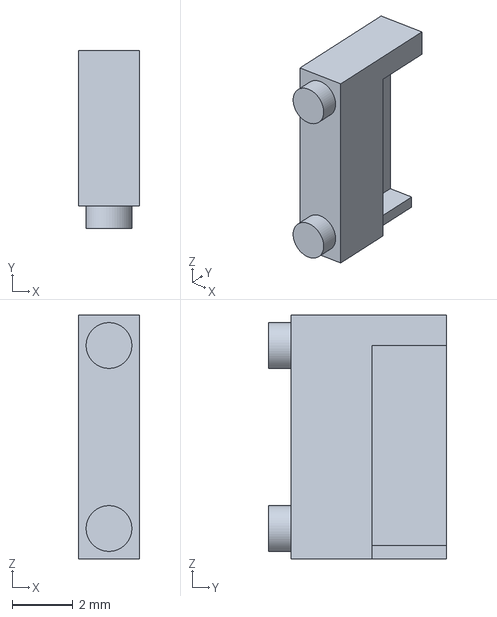
[picture p58: CAD file, 2023-11-07]
production/stp/microscope/microscope_mirrorcage_mk1.stp
2.00 x 5.85 x 8.00 mm
