rlemubaghs/open_mrscope/open_mrscope_mk2/production_nothread/stp/microscope/microscope_spacer_mk1.stp

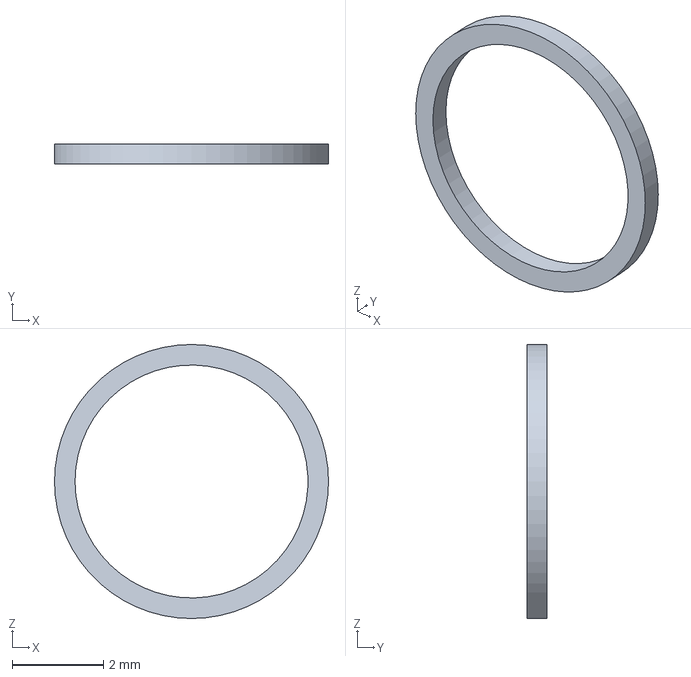
[picture p59: CAD file, 2025-03-11]
open_mrscope_mk2/production_nothread/stp/microscope/microscope_spacer_mk1.stp
6.00 x 0.436 x 6.00 mm
