rlemubaghs/open_mrscope/open_mrscope_mk2/production_nothread/stp/optics/simulation/lens_47690_ext_1.stp

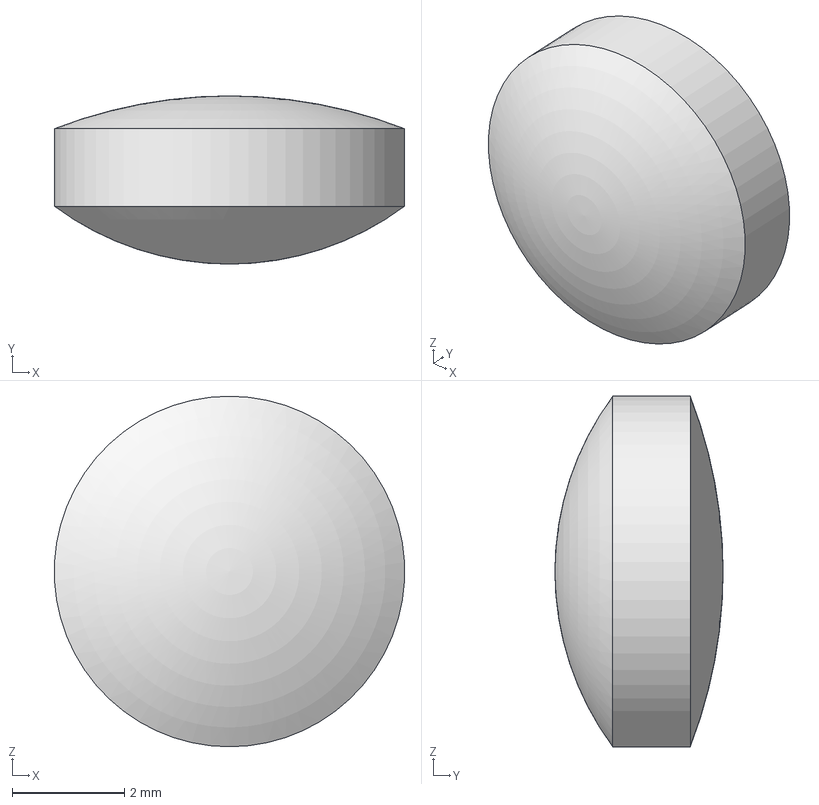
[picture p60: CAD file, 2025-03-11]
open_mrscope_mk2/production_nothread/stp/optics/simulation/lens_47690_ext_1.stp
6.24 x 3.00 x 6.25 mm
