rlemubaghs/open_mrscope/production/stp/microscope/microscope_stabilizer_mk1.stp

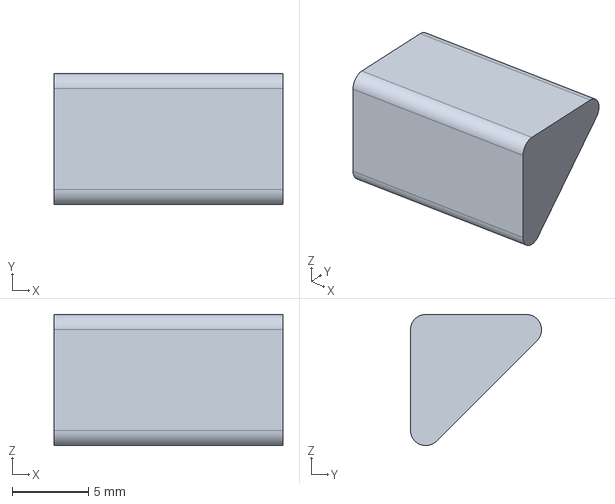
[picture p62: CAD file, 2023-11-07]
production/stp/microscope/microscope_stabilizer_mk1.stp
15.0 x 8.58 x 8.58 mm
