rlemubaghs/open_mrscope/open_mrscope_mk2/production_thread/stp/microscope/microscope_filtercube_mk1.stp

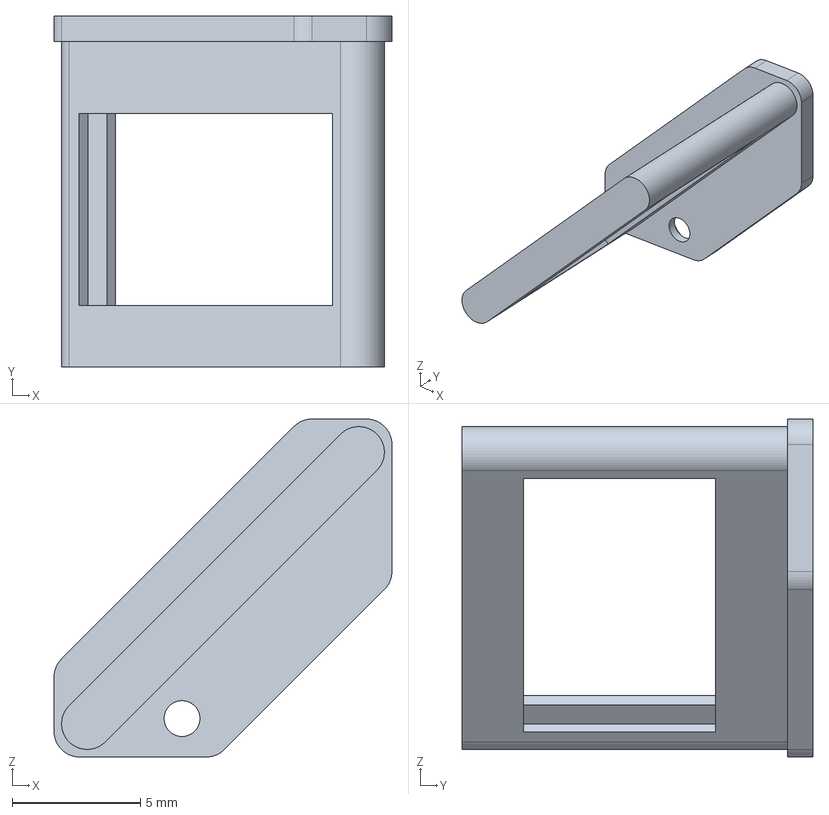
[picture p63: CAD file, 2025-03-11]
open_mrscope_mk2/production_thread/stp/microscope/microscope_filtercube_mk1.stp
13.2 x 13.7 x 13.2 mm
