rlemubaghs/open_mrscope/production/stp/microscope/microscope_objective_mk1.stp

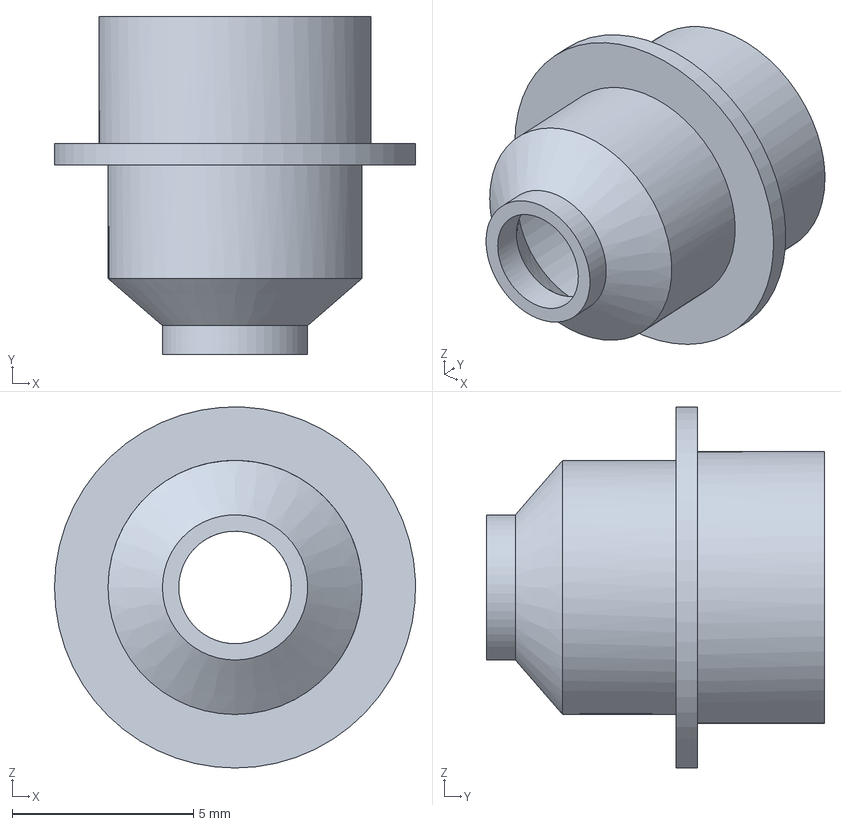
[picture p64: CAD file, 2023-11-07]
production/stp/microscope/microscope_objective_mk1.stp
9.95 x 9.33 x 9.95 mm
