rlemubaghs/open_mrscope/open_mrscope_mk2/production_nothread/stp/microscope/microscope_objective_mk1.stp

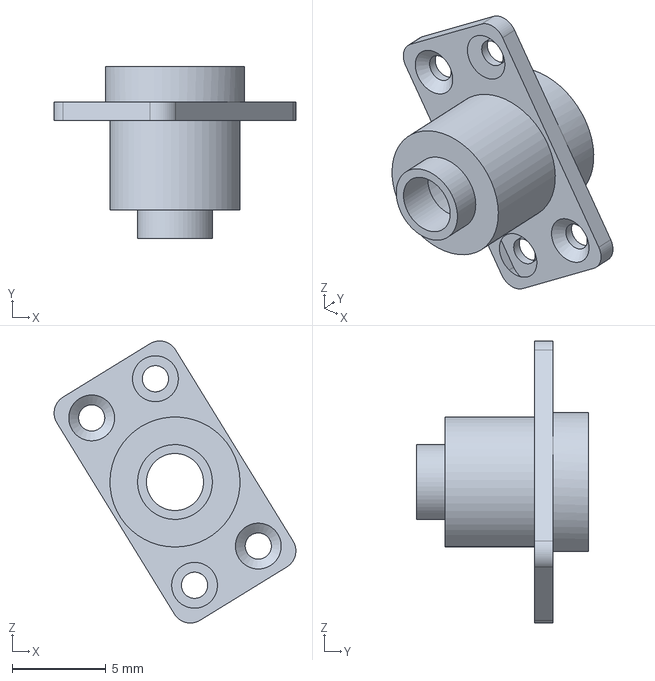
[picture p65: CAD file, 2025-03-11]
open_mrscope_mk2/production_nothread/stp/microscope/microscope_objective_mk1.stp
12.9 x 9.20 x 15.1 mm
