rlemubaghs/open_mrscope/open_mrscope_mk2/production_nothread/stp/optics/simulation/simulation_mrscope_ext.stp

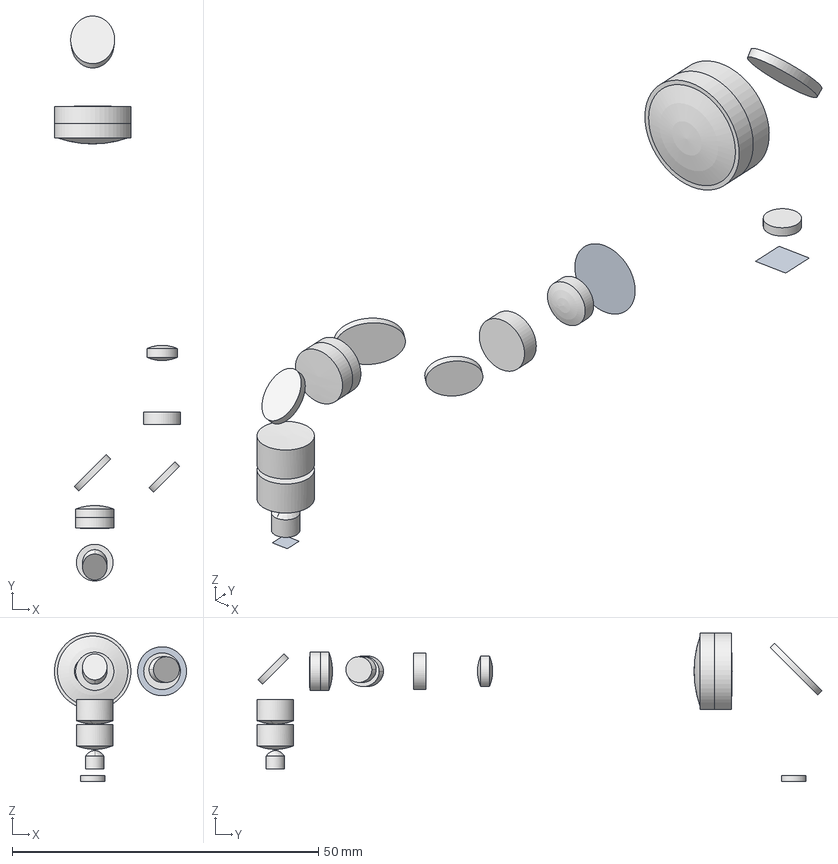
[picture p66: CAD file, 2025-03-11]
open_mrscope_mk2/production_nothread/stp/optics/simulation/simulation_mrscope_ext.stp
21.6 x 92.3 x 28.2 mm
