rlemubaghs/open_mrscope/(list of files, cad)

Other CAD files:
open_mrscope_mk2/production_thread/stp/assemblies/assemblies_opticalsystem.stp
open_mrscope_mk2/production_thread/stp/assemblies/assemblies_microscope.stp
open_mrscope_mk2/production_nothread/stl/optics/simulation/lens_15271_ext.stl
open_mrscope_mk2/production_thread/stl/optics/lenses/lens_36629_ext.stl
open_mrscope_mk2/production_thread/stp/construction/construction_objective_mk1.stp
production/stp/optics/lenses/lens_36629_ext.stp
open_mrscope_mk2/production_nothread/stp/optics/mirrors/mirror_mirror5x8mm_ext.stp
open_mrscope_mk2/production_nothread/stp/peripherals/peripheral_fiber_ext.stp
open_mrscope_mk2/production_thread/stl/optics/mirrors/mirror_mirror16x11mm_ext.stl
open_mrscope_mk2/production_thread/stl/peripherals/peripheral_camera_ext.stl
open_mrscope_mk2/production_thread/stp/optics/filters/filter_emmiter_ext.stp
open_mrscope_mk2/production_nothread/stp/microscope/microscope_support_mk1.stp
open_mrscope_mk2/production_thread/stl/optics/simulation/camera.stl
open_mrscope_mk2/production_thread/stp/adaptors/adaptor_lightsource_mk1.stp
open_mrscope_mk2/production_thread/stp/microscope/microscope_supportlock_mk1.stp
open_mrscope_mk2/production_thread/stp/optics/lenses/lens_47690_ext.stp
production/stp/optics/filters/filter_diffuser_ext.stp
open_mrscope_mk2/production_nothread/stp/adaptors/adaptor_cameralock_mk1.stp
open_mrscope_mk2/production_nothread/stp/optics/simulation/lens_63594_ext.stp
open_mrscope_mk2/production_thread/stl/optics/simulation/lens_63594_ext.stl
open_mrscope_mk2/production_thread/stp/adaptors/adaptor_lightsourceangle_mk1.stp
open_mrscope_mk2/production_thread/stp/optics/lenses/lens_15271_ext.stp
open_mrscope_mk2/production_thread/stp/optics/simulation/lens_15271_ext.stp
open_mrscope_mk2/production_thread/stp/microscope/microscope_objectivecoupler_mk1.stp
open_mrscope_mk2/production_thread/stp/optics/simulation/lens_36629_ext_1.stp
open_mrscope_mk2/production_thread/stl/optics/simulation/object.stl
open_mrscope_mk2/production_thread/stp/optics/simulation/filter_diffuser_ext.stp
open_mrscope_mk2/production_nothread/stp/microscope/microscope_mirrorlockfront_mk1.stp
open_mrscope_mk2/production_nothread/stp/optics/simulation/filter_emmiter_ext.stp
open_mrscope_mk2/production_thread/stp/microscope/microscope_mirrorlockback_mk1.stp
open_mrscope_mk2/production_nothread/stp/microscope/microscope_mirrorlocktop_mk1.stp
open_mrscope_mk2/production_nothread/stp/optics/simulation/filter_dichroic_ext.stp
open_mrscope_mk2/production_thread/stp/microscope/microscope_spacer_mk1.stp
open_mrscope_mk2/production_nothread/stp/microscope/microscope_filtercube_mk1.stp
open_mrscope_mk2/production_thread/stp/microscope/microscope_cameracoupler_mk1.stp
deprecated/open_mrscope_mk1/production/ipt/adaptors/adaptor_camera_mk1.ipt
deprecated/open_mrscope_mk1/production/ipt/assemblies/assemblies_construction.iam
deprecated/open_mrscope_mk1/production/ipt/assemblies/assemblies_microscope.iam
deprecated/open_mrscope_mk1/production/ipt/assemblies/assemblies_opticalsystem.iam
deprecated/open_mrscope_mk1/production/ipt/microscope/microscope_stabilizer_mk1.ipt
deprecated/open_mrscope_mk1/production/ipt/microscope/microscope_top_mk1.ipt
deprecated/open_mrscope_mk1/production/ipt/optics/filters/filter_dichroic_ext.ipt
deprecated/open_mrscope_mk1/production/ipt/optics/filters/filter_diffuser_ext.ipt
deprecated/open_mrscope_mk1/production/ipt/optics/filters/filter_emmiter_ext.ipt
deprecated/open_mrscope_mk1/production/ipt/optics/lenses/lens_15271_ext.ipt
deprecated/open_mrscope_mk1/production/ipt/optics/lenses/lens_47690_ext.ipt
deprecated/open_mrscope_mk1/production/ipt/optics/lenses/lens_63594_ext.ipt
deprecated/open_mrscope_mk1/production/ipt/optics/mirrors/mirror_mirror5x7mm_ext.ipt
deprecated/open_mrscope_mk1/production/ipt/optics/mirrors/mirror_mirror8x11mm_ext.ipt
deprecated/open_mrscope_mk1/production/ipt/peripherals/peripheral_camera_ext.ipt
deprecated/open_mrscope_mk1/production/stl/adaptors/adaptor_camera_mk1.stl
deprecated/open_mrscope_mk1/production/stl/microscope/microscope_base_mk1.stl
deprecated/open_mrscope_mk1/production/stl/microscope/microscope_mirrorcage_mk1.stl
deprecated/open_mrscope_mk1/production/stl/microscope/microscope_spacer_mk1.stl
deprecated/open_mrscope_mk1/production/stl/microscope/microscope_support_mk1.stl
deprecated/open_mrscope_mk1/production/stl/optics/filters/filter_diffuser_ext.stl
deprecated/open_mrscope_mk1/production/stl/optics/lenses/lens_15271_ext.stl
deprecated/open_mrscope_mk1/production/stl/optics/lenses/lens_47662_ext.stl
deprecated/open_mrscope_mk1/production/stl/optics/mirrors/mirror_mirror10x16mm_ext.stl
deprecated/open_mrscope_mk1/production/stl/optics/mirrors/mirror_mirror5x7mm_ext.stl
deprecated/open_mrscope_mk1/production/stl/peripherals/peripheral_camera_ext.stl
deprecated/open_mrscope_mk1/production/stp/adaptors/adaptor_camera_mk1.stp
deprecated/open_mrscope_mk1/production/stp/optics/filters/filter_diffuser_ext.stp
deprecated/open_mrscope_mk1/production/stp/optics/filters/filter_emmiter_ext.stp
deprecated/open_mrscope_mk1/production/stp/optics/lenses/lens_36629_ext.stp
deprecated/open_mrscope_mk1/production/stp/optics/lenses/lens_47662_ext.stp
deprecated/open_mrscope_mk1/production/stp/optics/lenses/lens_47690_ext.stp
deprecated/open_mrscope_mk1/production/stp/peripherals/peripheral_camera_ext.stp
open_mrscope_mk2/production_nothread/ipt/adaptors/adaptor_camera_mk1.ipt
open_mrscope_mk2/production_nothread/ipt/adaptors/adaptor_cameralock_mk1.ipt
open_mrscope_mk2/production_nothread/ipt/adaptors/adaptor_lightsource_mk1.ipt
open_mrscope_mk2/production_nothread/ipt/adaptors/adaptor_lightsourceangle_mk1.ipt
open_mrscope_mk2/production_nothread/ipt/assemblies/assemblies_microscope.iam
open_mrscope_mk2/production_nothread/ipt/assemblies/assemblies_opticalsystem.iam
open_mrscope_mk2/production_nothread/ipt/construction/construction_objective_mk1.ipt
open_mrscope_mk2/production_nothread/ipt/microscope/microscope_cameracoupler_mk1.ipt
open_mrscope_mk2/production_nothread/ipt/microscope/microscope_filtercube_mk1.ipt
open_mrscope_mk2/production_nothread/ipt/microscope/microscope_mirrorlockback_mk1.ipt
open_mrscope_mk2/production_nothread/ipt/microscope/microscope_mirrorlockfront_mk1.ipt
open_mrscope_mk2/production_nothread/ipt/microscope/microscope_mirrorlocktop_mk1.ipt
open_mrscope_mk2/production_nothread/ipt/microscope/microscope_objective_mk1.ipt
open_mrscope_mk2/production_nothread/ipt/microscope/microscope_objectivecoupler_mk1.ipt
open_mrscope_mk2/production_nothread/ipt/microscope/microscope_opticaltube_mk1.ipt
open_mrscope_mk2/production_nothread/ipt/microscope/microscope_spacer_mk1.ipt
open_mrscope_mk2/production_nothread/ipt/microscope/microscope_support_mk1.ipt
open_mrscope_mk2/production_nothread/ipt/microscope/microscope_supportlock_mk1.ipt
open_mrscope_mk2/production_nothread/ipt/optics/filters/filter_dichroic_ext.ipt
open_mrscope_mk2/production_nothread/ipt/optics/filters/filter_diffuser_ext.ipt
open_mrscope_mk2/production_nothread/ipt/optics/filters/filter_emmiter_ext.ipt
open_mrscope_mk2/production_nothread/ipt/optics/mirrors/mirror_mirror5x8mm_ext.ipt
open_mrscope_mk2/production_nothread/ipt/optics/mirrors/mirror_mirror8x11mm_ext.ipt
open_mrscope_mk2/production_nothread/ipt/optics/simulation/filter_dichroic_ext.ipt
open_mrscope_mk2/production_nothread/ipt/optics/simulation/filter_diffuser_ext.ipt
open_mrscope_mk2/production_nothread/ipt/optics/simulation/filter_emmiter_ext.ipt
open_mrscope_mk2/production_nothread/ipt/optics/simulation/lens_15271_ext.ipt
open_mrscope_mk2/production_nothread/ipt/optics/simulation/lens_47662_ext_2.ipt
open_mrscope_mk2/production_nothread/ipt/optics/simulation/lens_47690_ext_2.ipt
open_mrscope_mk2/production_nothread/ipt/optics/simulation/lens_63594_ext.ipt
open_mrscope_mk2/production_nothread/ipt/optics/simulation/light_source.ipt
open_mrscope_mk2/production_nothread/ipt/optics/simulation/mirror_mirror10x16mm_ext.ipt
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
