rlemubaghs/open_mrscope/documentation/images/microscope_build.png

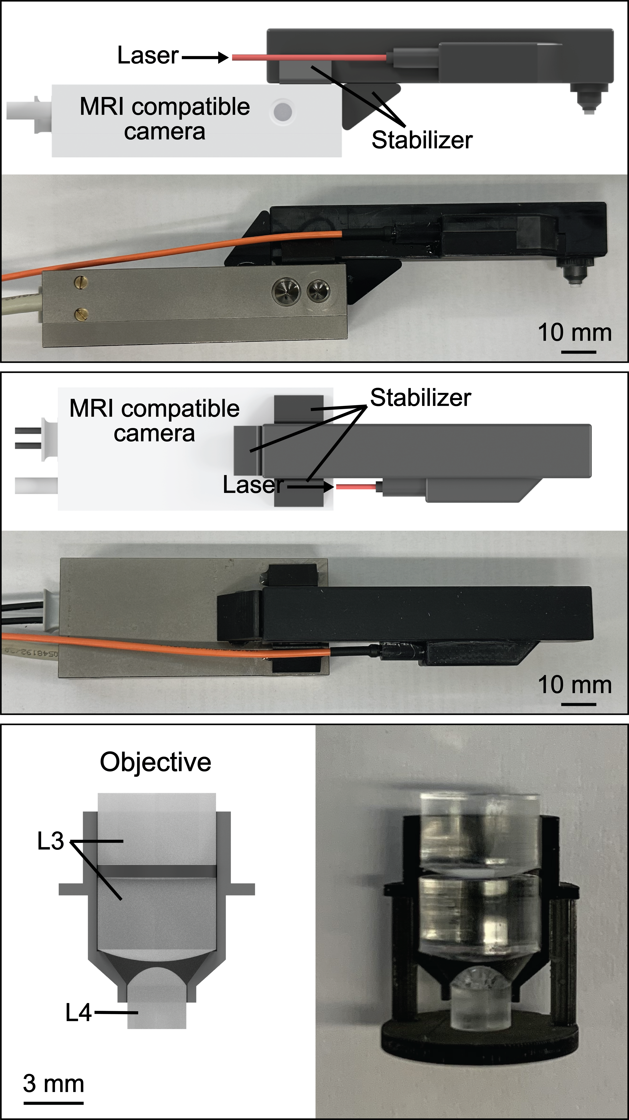
documentation/images/microscope_build.png
